dmcsvoices/Handoff-Case/designs/handoff_case/IMG_20261020_133205997.jpg

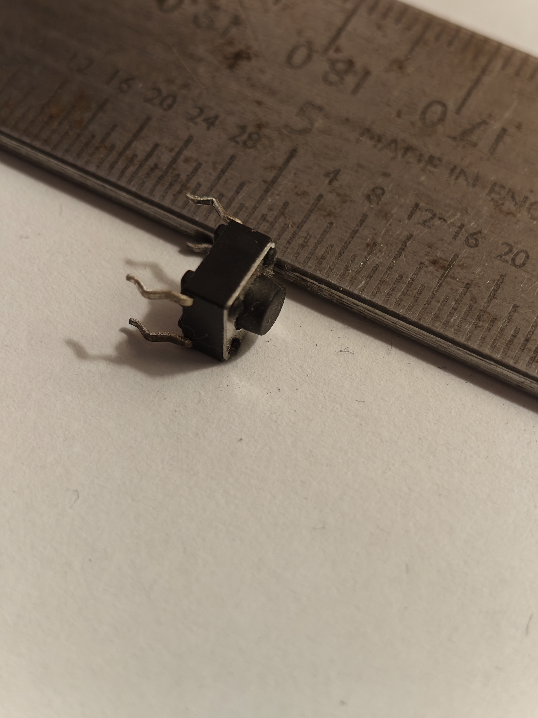
designs/handoff_case/IMG_20261020_133205997.jpg
