dmcsvoices/Handoff-Case/plans/current/index.md

# Current Plans Index

Format: `created_at | path | title | summary`

2026-10-29-20-30-00 | plans/current/2026-10-29-20-30-00_handoff-case-rev2-feedback.md | Handoff Case rev_0002 — physical print feedback + button holding slots | Apply 2026-10-29 caliper/print feedback (board 57.1, USB shells 4.4, OLED 31.0 rigid, microSD module, button 5.4 mm body) and replace button wells with side-entry holding slots that accept pre-wired switches, as immutable rev_0002.
2026-10-20-14-26-10 | plans/current/2026-10-20-14-26-10_handoff-case.md | Handoff Case — ESP32-S3 IoT Device Enclosure | Design a governed OpenSCAD enclosure for an ESP32-S3 DevKitC, microSD reader module + card, 1.3" I2C OLED, and two tactile buttons, from a fresh pipeline scaffold using ruler-photo measurements.
2026-10-16-22-00-00 | plans/current/2026-10-16-22-00-00_cicero-head-gravity-joints.md | Implement gravity-seated joints for the Cicero head | Resolve a continuous neck owner, add installable head joints, and verify flat-bed outputs.
2026-10-04-11-35-16 | plans/current/2026-10-04-11-35-16_create-6u-cyberdeck.md | Create 6u_cyberdeck 6U ten-inch-rack case (80 mm deep) | Build a new standalone 6U ten-inch-rack case (254 x 293.9 x 80 mm outer, 222.25 x 266.7 mm clear opening) split into four printable quadrant leaves joined by M3 captive-nut registration seam stations; ring band 13.6 mm independently derived from the M3 station starting profile.
2026-09-18-12-00-00 | plans/current/2026-09-18-12-00-00_fan-guard.md | Micro Cyberdeck Fan Guard | Add a new single-part fan guard design — a flat plate on 3 mm standoffs with four M3-bore studs — that sits outside the case's 40 mm fan, keeps airflow in through the sides and center, and protects the spinning blades.
2026-09-18-07-21-14 | plans/current/2026-09-18-07-21-14_solarpunk-seed-tray-bell-bumpout.md | Solarpunk Seed Tray — Bell Bump-Out | Move the siphon out of the tray footprint into a side bump-out sized for an ~8 cm bottle, with a center siphon exit, 8 support spines (~5 mm), and a drain outlet on the bump-out outer face; 12-cell (rev_0001) is the primary reference.
2026-09-17-16-59-53 | plans/current/2026-09-17-16-59-53_solarpunk-seed-tray-parametric-scaffold.md | Solarpunk Seed Tray Parametric Scaffold | Build the fully-parametric solarpunk_seed_tray OpenSCAD source, two placeholder configs (12-cell and 6-cell kits), reference mockups, and manifest/assembly governance so adding a size never requires editing src/.
2026-09-09-19-21-26 | plans/current/2026-09-09-19-21-26_create-cyberdeck-2-5u-enclosure.md | Create cyberdeck-2 5U fully-enclosed rack case | Build a new 5U ten-inch-rack case (254 x 254 x 80 mm), fully enclosed except the 222.25 x 222.25 mm rack opening, split into four printable quadrant leaves joined by eight M3 captive-nut registration seam stations (two per seam ribbon) located in the ring band between the rack clear opening and the case edge.
2026-08-31-12-58-00 | plans/current/2026-08-31-12-58-00_triple-thor-geometry-blockout.md | Triple Thor Enclosure Geometry Blockout | Scaffold parametric OpenSCAD blockout geometry, parts manifest, assembly contract, and config for the triple_thor_enclosure at locked R=57mm layout.
2026-08-13-17-44-00 | plans/current/2026-08-13-17-44-00_restore-angled-screen-2u-rails.md | Restore Distinct Angled-Screen 2U Rails | Separate the angled-screen rail, hardware-back, and exterior-closure owners so the screen presents two clear 2U rail columns rather than solid end-wall blocks.
2026-08-04-19-34-43 | plans/current/2026-08-04-19-34-43_migrate-agents-to-agentic-pipelines.md | Migrate the Agent Framework to Agentic Pipelines | Replace the agents submodule with agentic-pipelines at ./agentic-pipelines while preserving and validating host-owned CAD governance.
2026-08-03-11-23-45 | plans/current/2026-08-03-11-23-45_relocate-upper-seam-and-fastener-rail.md | Connect the High Screen Roof and Relocate the Upper Front Seam | Add a clearance-neutral interlocking seam to the highest screen roof, move the closed-front upper seam into its inside wall, and reduce chamber height only if the full upper load path remains verified.
