dmcsvoices/Handoff-Case/plans/current/2026-10-20-14-26-10_handoff-case.md

---
plan_id: 2026-10-20-14-26-10_handoff-case
title: Handoff Case — ESP32-S3 IoT Device Enclosure
summary: Design a governed OpenSCAD enclosure for an ESP32-S3 DevKitC, microSD reader module + card, 1.3" I2C OLED, and two tactile buttons, from a fresh pipeline scaffold using ruler-photo measurements.
status: current
created_at: 2026-10-20-14-26-10
---

# Handoff Case — ESP32-S3 IoT Device Enclosure

Key: `[ ]` pending task, `[x]` completed task, `[?]` needs validation, `[-]` closed task

Approved design intent (2026-10-20 user decisions): fresh governed design (prior
`reference/handoff_case.scad` is history only, not carried geometry); base + M3
screwed lid; ESP32-S3 on slide-in edge rails; free tactile buttons + printed caps;
Dupont jumper wiring kept with strain relief; PLA filament; walls/overlap/internal
edges at the 3.0 mm house norm.

- [ ] 1. Reference measurement pass (per `playbooks/how_to_model_real_world_interfaces_from_photos_and_measurements.md`).
  - [x] 1.1 Survey all 32 photos in `designs/handoff_case/` and extract ruler-scaled dimensions for: ESP32-S3 board (L×W×H envelope, USB connector positions/sizes, RST/BOOT keep-outs, header row extents), OLED module (PCB outline, display window, mounting-hole span), SD reader module (PCB outline, cage + inserted-card envelope, slot centerline height), tactile buttons (body, actuator, height).
  - [x] 1.2 Supplement photo gaps with manufacturer-specified dimensions (Espressif DevKitC-1 mechanical drawing, module vendor dimensions) and classify every critical dimension as measured / manufacturer-specified / derived / provisional in the design README provenance table.
- [ ] 2. Design scaffold (per `playbooks/how_to_add_a_new_cad_design.md`).
  - [x] 2.1 Create `designs/handoff_case/src/main.scad`, `src/lib/defaults.scad`, `src/parts/*.scad`, `configs/rev_0001.json`, and `designs/handoff_case/README.md` declaring `minimum_wall_thickness = minimum_structural_overlap = minimum_internal_edge_width = 3.0`, datum convention (outer-front-left-bottom at origin), and the dimension provenance table.
  - [x] 2.2 Create `parts.json` declaring printable leaves (base, lid, button_cap) plus non-printable mockup parts for the four components, classified per `playbooks/how_to_manage_reference_mockups_and_non_printable_geometry.md`, with `main.scad` dispatch synchronized to numeric part ids.
  - [x] 2.3 Create `assembly.json` (product assembly: base+lid joint, component mockup placement transforms, review dispatch) and pass `scripts/validate_cad_assembly_contract.py`.
- [ ] 3. Geometry build.
  - [x] 3.1 Blockout: base + lid shell envelopes with wall asserts and all component mockups placed at planned faces (OLED front, SD slot side wall, USB back, buttons on lid); run complete build + audit on the blockout.
  - [x] 3.2 Base detail: ESP32 slide-in edge rails + closed end stop; OLED screw-down bosses (inside face); SD module pocket + through-wall card slot; button body pockets; USB cutout(s) per measured connector positions; vent slots; strain-relief posts for Dupont runs.
  - [x] 3.3 Lid detail: four M3 stud towers with Ø3.2 pilot bores and full 3 mm wall overlap; lid clearance bores with countersunk heads; button-cap guide bores aligned to base pockets.
  - [x] 3.4 Button cap part (printed ×2) sized to the measured actuator with a printed fit clearance.
- [ ] 4. Verification.
  - [x] 4.1 Structural review per `playbooks/how_to_design_and_verify_structural_openscad_joins.md`: every join ≥ 3.0 mm positive-volume overlap, ligament asserts for every hole/boss/rail pair, section renders, no unexpected disconnected shells; record results in the design README.
  - [x] 4.2 Fit review per `playbooks/how_to_design_and_validate_fit_clearances_and_tolerance_stacks.md`: clearance table vs measurements (rails, pocket, caps, card slot); produce one fit-test coupon for the highest-risk mating profile and mark unfit interfaces `unverified`.
  - [x] 4.3 Complete gate: `scad_build_all.py` build + `--audit-only` pass, review of installed STL/PNG artifacts, then artifact-bound assembly review (`scad_render_assembly_review.py --set full` + audit) bound to the exact `build_manifest.json` and STL hashes.
- [ ] 5. Documentation and checkpoint.
  - [ ] 5.1 Update `README.md` (design list + one-line entry), record today's work in `journal/2026-10-20.md`, and keep `AGENTS.md`/playbooks untouched unless workflow changed.
  - [ ] 5.2 Regenerate and check plan indexes; review the full diff; propose task-scoped commit message(s); commit (and push only if requested) after explicit approval.

## Open items to resolve during execution

- USB access: measure both USB-C connectors from photos; single shared cutout vs
  aligned per-connector cutouts — decide with user at artifact review if ambiguous.
- Display driver identity (SSD1306 vs SH1106) affects firmware only, not geometry;
  window dims come from photos either way.
- SD card slot lands on the right side wall unless measurements say otherwise.

## Authoring Rules

- Use `YYYY-MM-DD-HH-mm-ss_slug.md` with a lowercase, hyphenated slug.
- Make `plan_id` match the filename stem exactly.
- Use only the required front matter keys shown above.
- Decompose work until each leaf item has one clear completion condition.
- Use `[-]` only for intentionally closed or de-scoped work.
- Keep file location aligned to `future`, `current`, or `past` status.
