dmcsvoices/Handoff-Case/designs/handoff_case/IMG_20261020_132310760.jpg

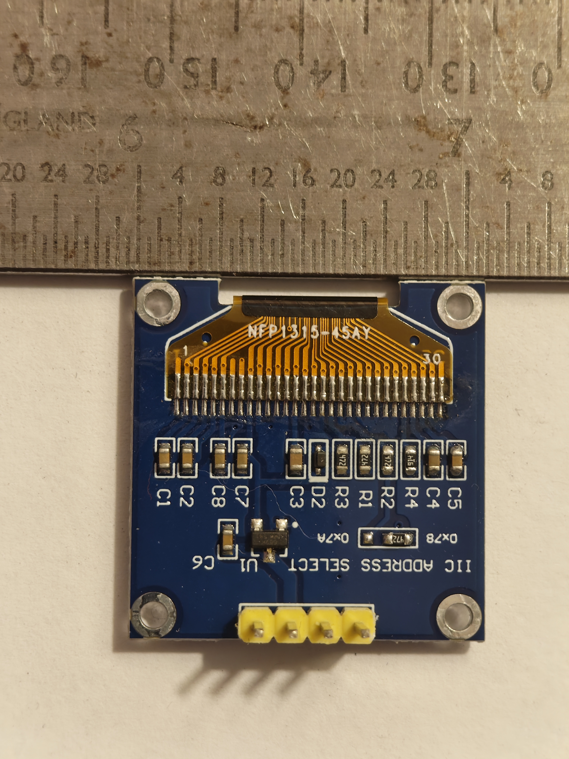
designs/handoff_case/IMG_20261020_132310760.jpg
