dmcsvoices/Handoff-Case/designs/handoff_case/IMG_20261020_132324795.jpg

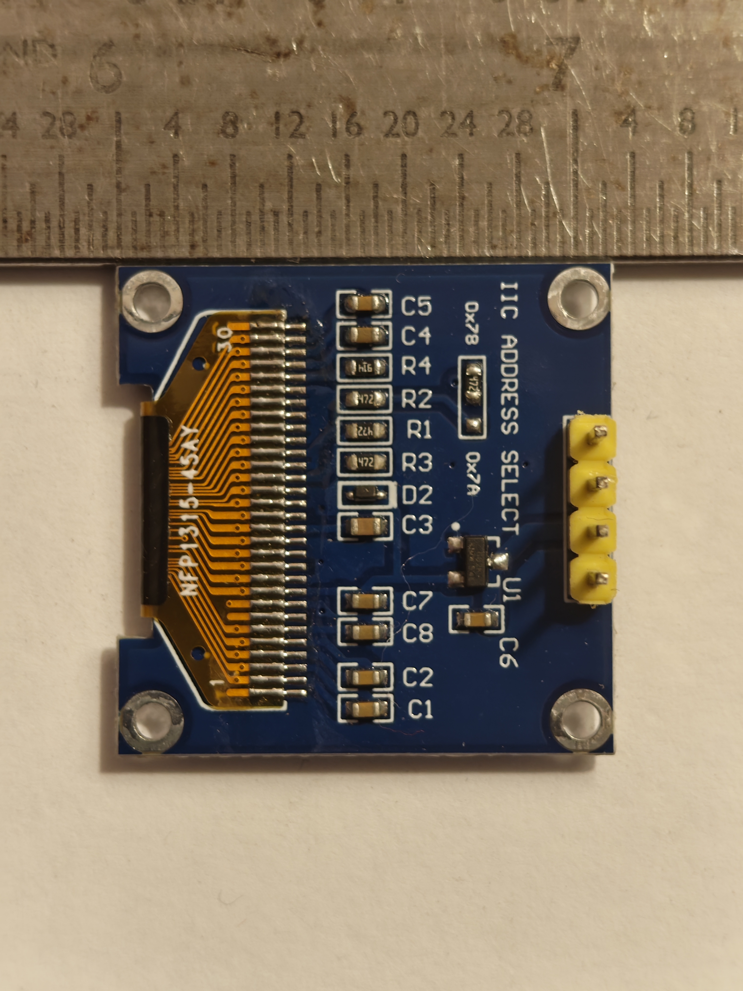
designs/handoff_case/IMG_20261020_132324795.jpg
