dmcsvoices/Handoff-Case/designs/handoff_case/IMG_20261020_132353154.jpg

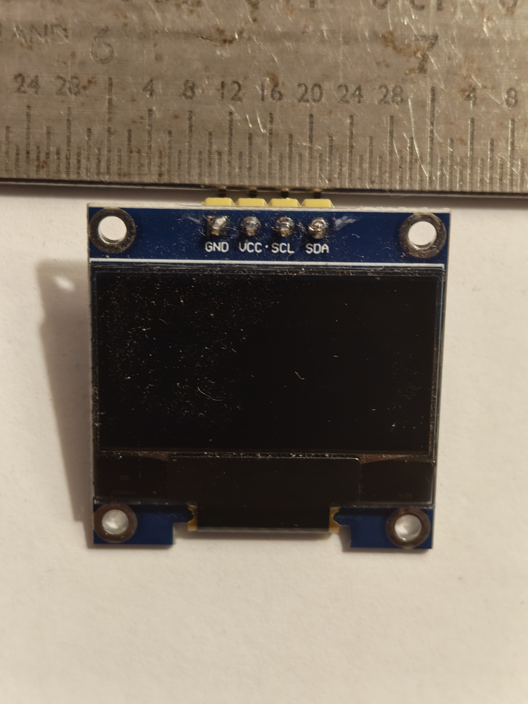
designs/handoff_case/IMG_20261020_132353154.jpg
