dmcsvoices/Handoff-Case/designs/handoff_case/IMG_20261020_132410037.jpg

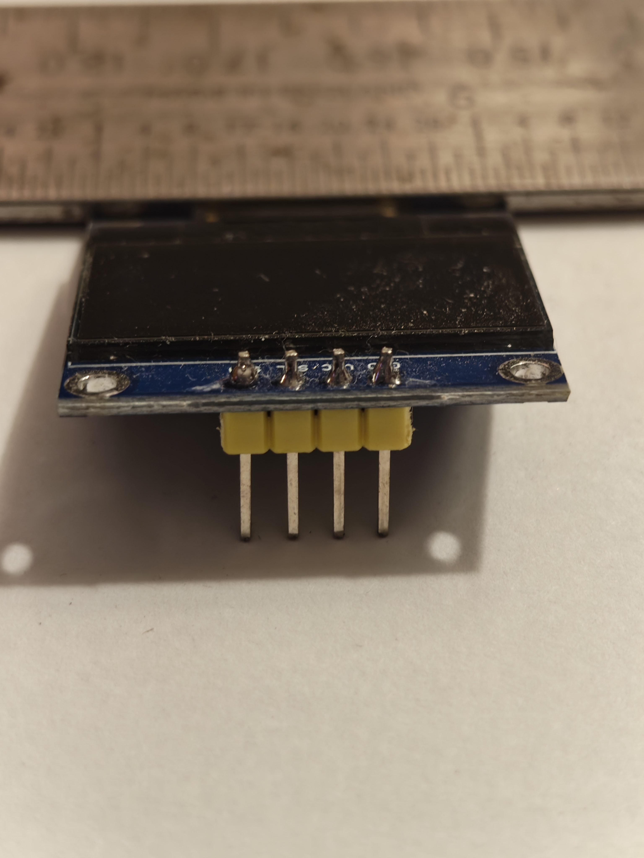
designs/handoff_case/IMG_20261020_132410037.jpg
