dmcsvoices/Handoff-Case/designs/handoff_case/IMG_20261020_132823366.jpg

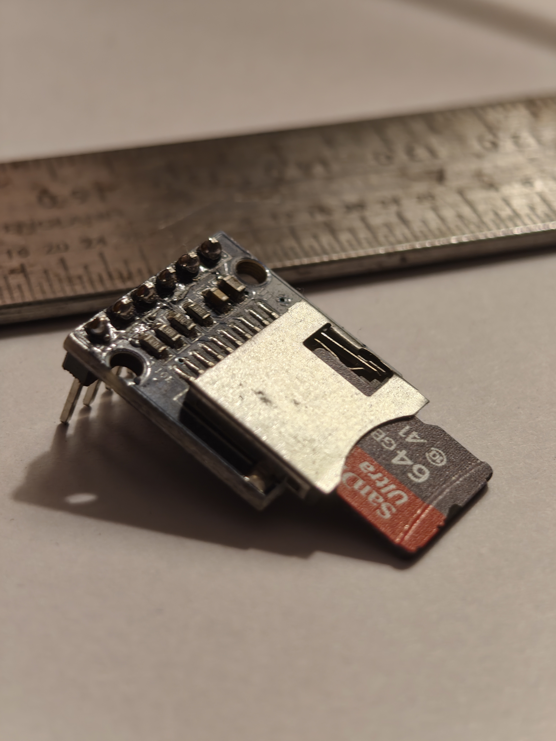
designs/handoff_case/IMG_20261020_132823366.jpg
