dmcsvoices/Handoff-Case/designs/handoff_case/IMG_20261020_132851913.jpg

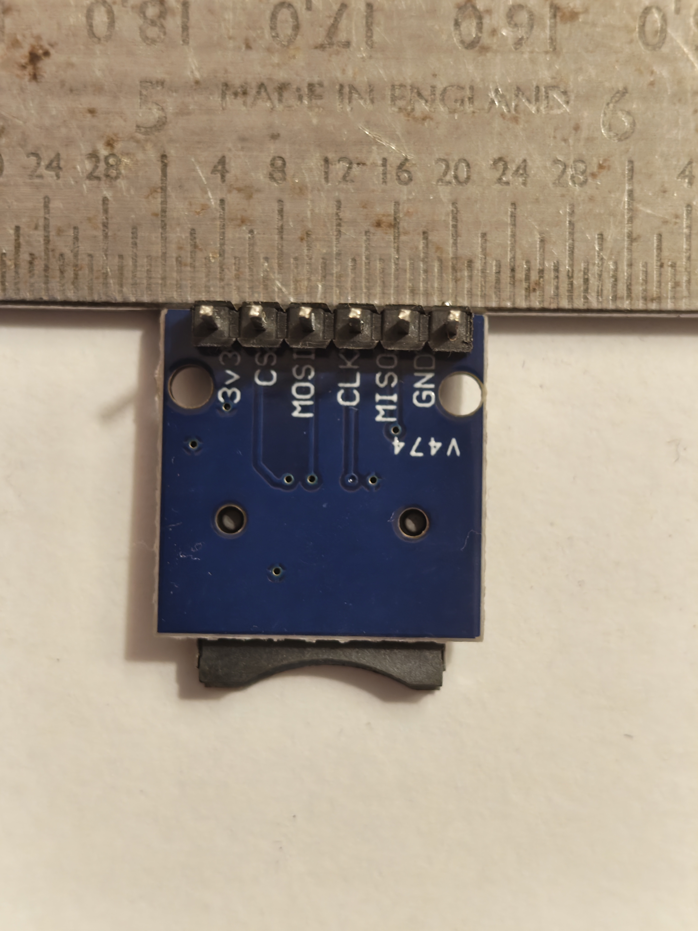
designs/handoff_case/IMG_20261020_132851913.jpg
