dmcsvoices/Handoff-Case/designs/handoff_case/IMG_20261020_132917582.jpg

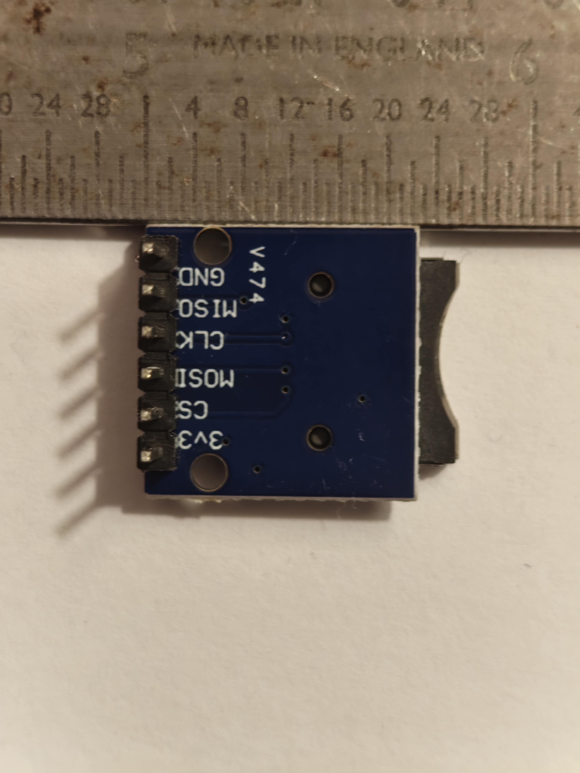
designs/handoff_case/IMG_20261020_132917582.jpg
