dmcsvoices/Handoff-Case/designs/handoff_case/IMG_20261020_132930378.jpg

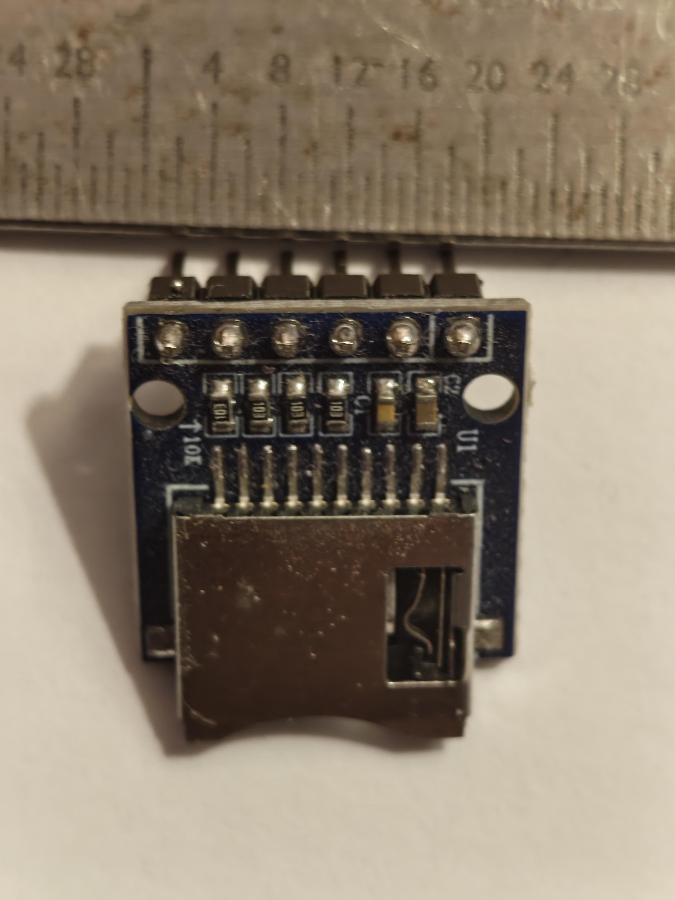
designs/handoff_case/IMG_20261020_132930378.jpg
