dmcsvoices/Handoff-Case/designs/handoff_case/IMG_20261020_132958653.jpg

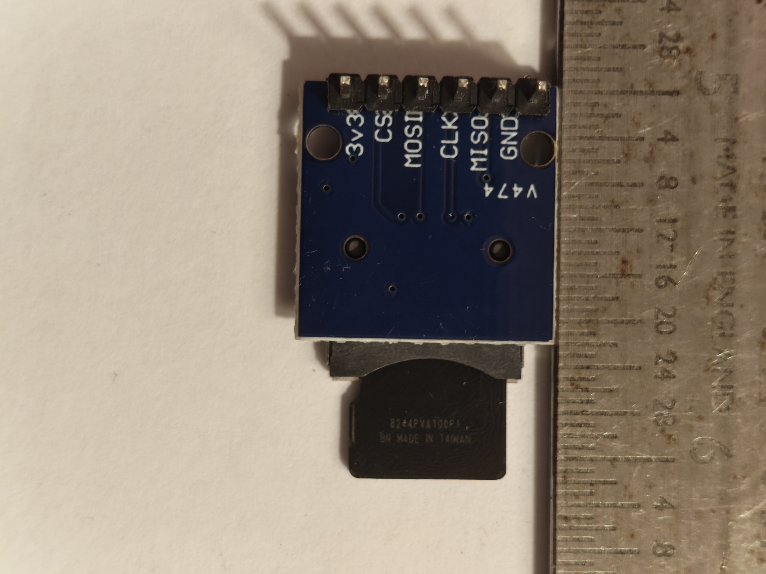
designs/handoff_case/IMG_20261020_132958653.jpg
