dmcsvoices/Handoff-Case/designs/handoff_case/IMG_20261020_133024415.jpg

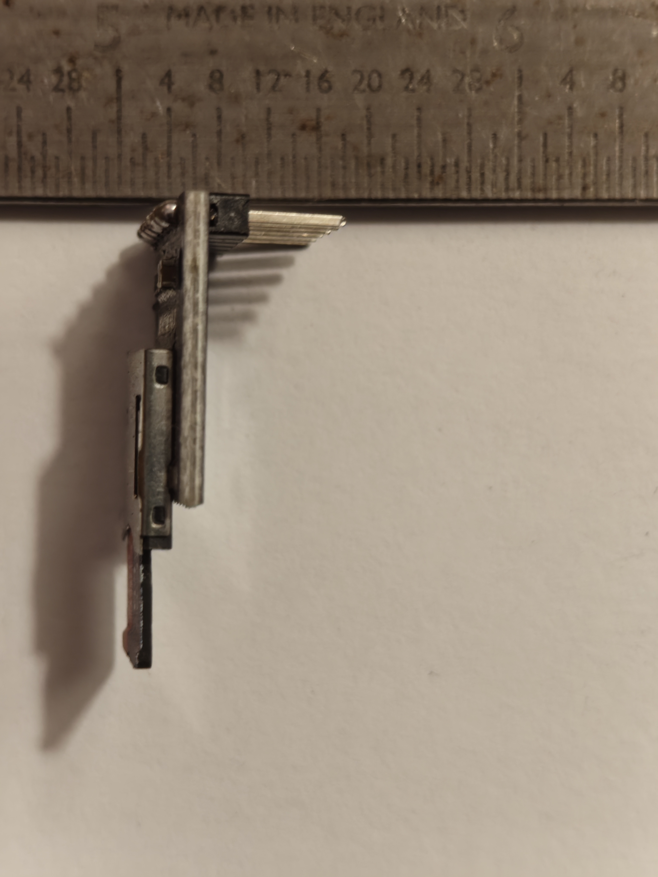
designs/handoff_case/IMG_20261020_133024415.jpg
