dmcsvoices/Handoff-Case/designs/handoff_case/IMG_20261020_133124452.jpg

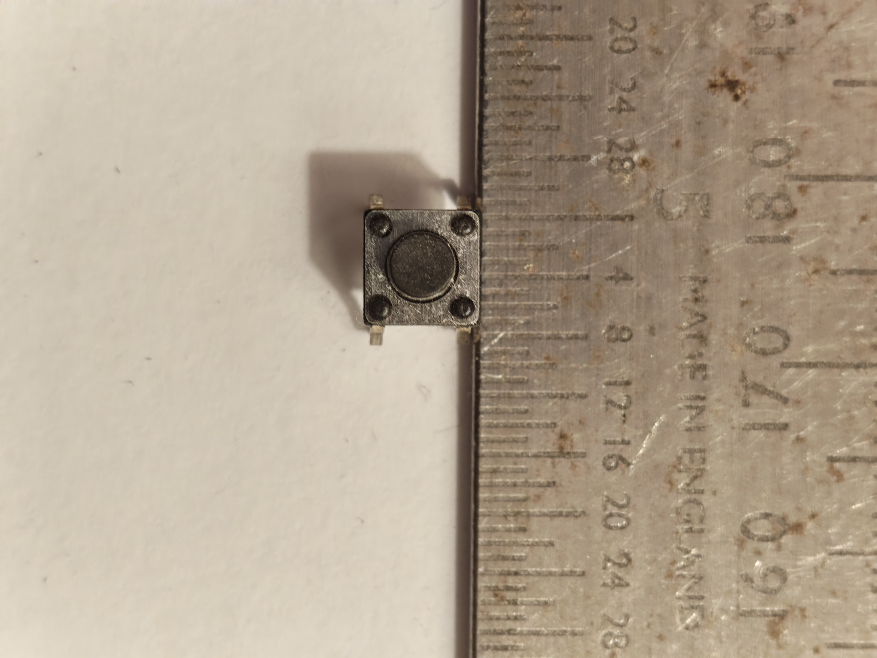
designs/handoff_case/IMG_20261020_133124452.jpg
