dmcsvoices/Handoff-Case/designs/handoff_case/IMG_20261020_133133115.jpg

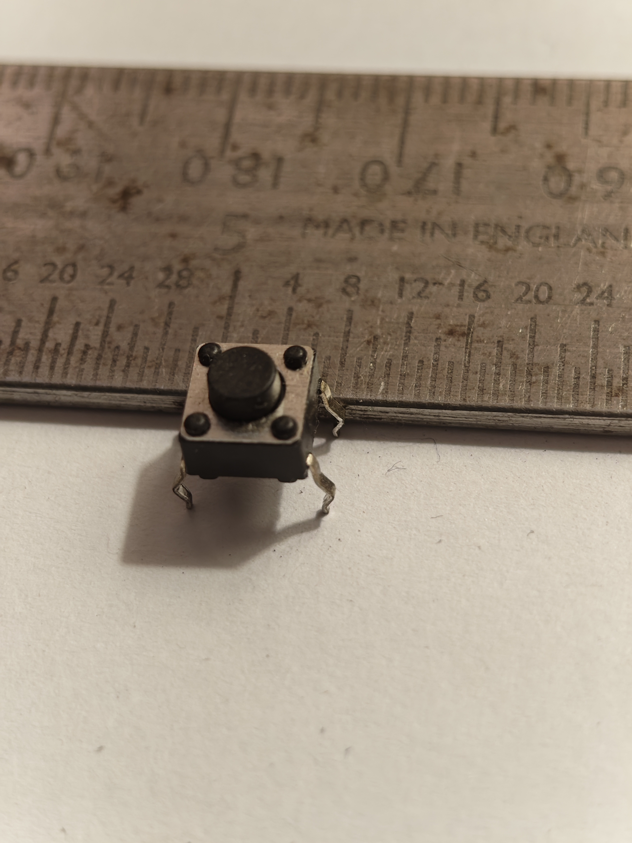
designs/handoff_case/IMG_20261020_133133115.jpg
