dmcsvoices/Handoff-Case/designs/handoff_case/IMG_20261020_133159837.jpg

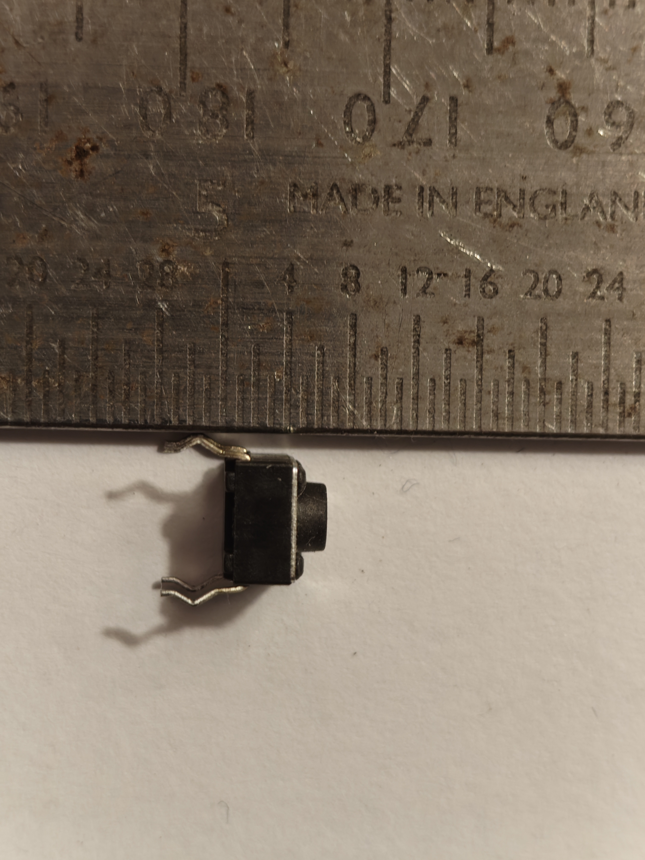
designs/handoff_case/IMG_20261020_133159837.jpg
