dmcsvoices/Handoff-Case/designs/handoff_case/IMG_20261020_133657593.jpg

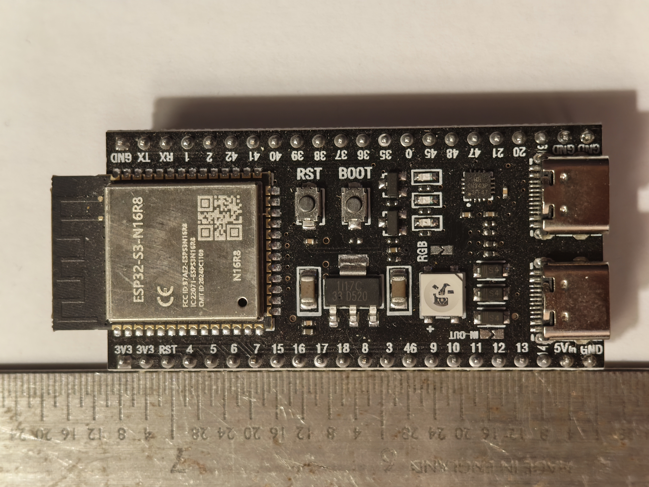
designs/handoff_case/IMG_20261020_133657593.jpg
