dmcsvoices/Handoff-Case/designs/handoff_case/IMG_20261020_133727599.jpg

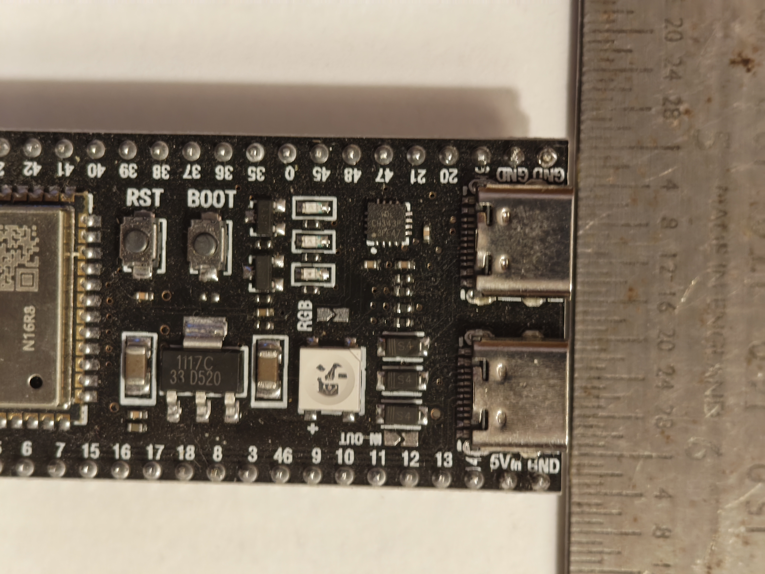
designs/handoff_case/IMG_20261020_133727599.jpg
