dmcsvoices/Handoff-Case/designs/handoff_case/IMG_20261020_133752373.jpg

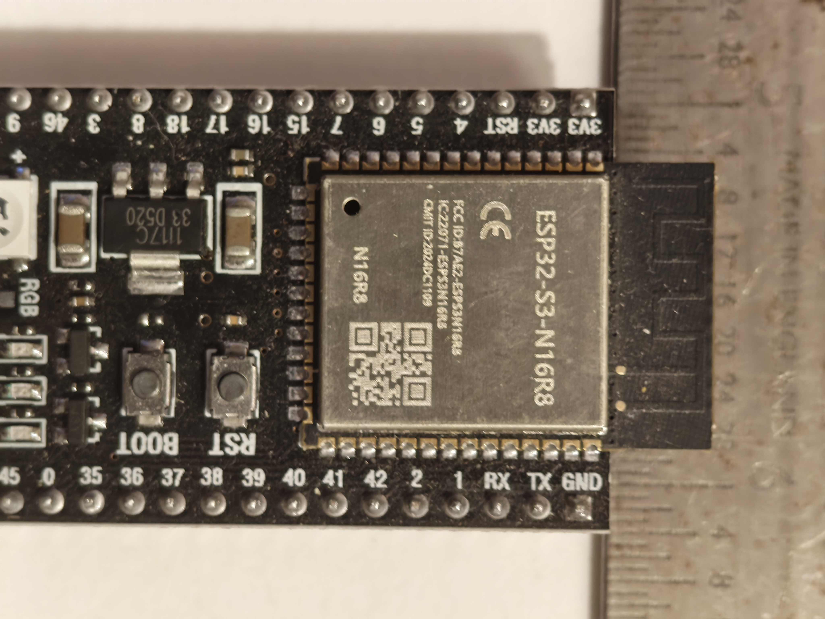
designs/handoff_case/IMG_20261020_133752373.jpg
