dmcsvoices/Handoff-Case/designs/handoff_case/IMG_20261020_133754685.jpg

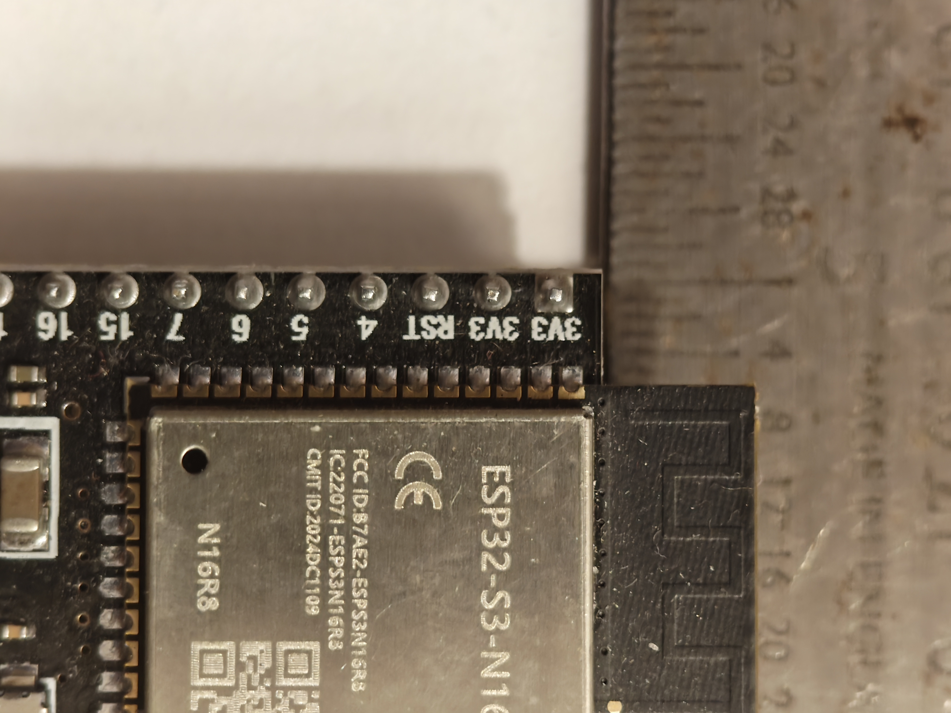
designs/handoff_case/IMG_20261020_133754685.jpg
