dmcsvoices/Handoff-Case/designs/handoff_case/IMG_20261020_133801292.jpg

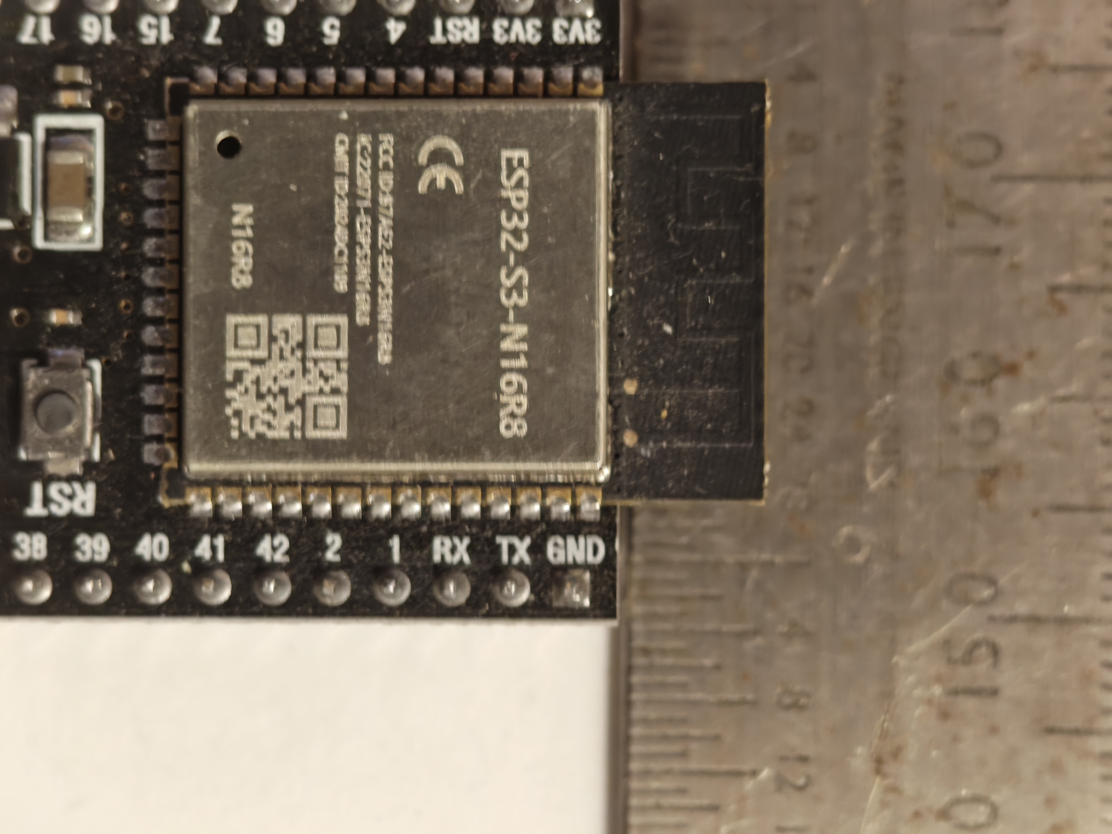
designs/handoff_case/IMG_20261020_133801292.jpg
