dmcsvoices/Handoff-Case/designs/handoff_case/IMG_20261020_133842431.jpg

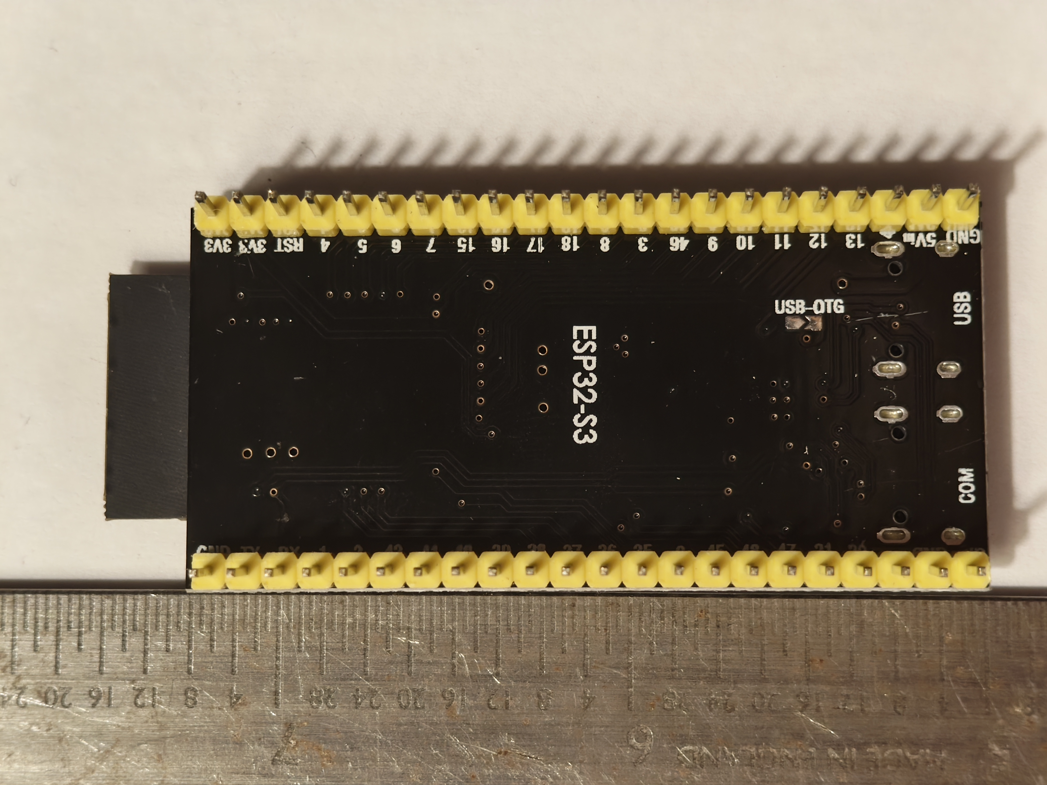
designs/handoff_case/IMG_20261020_133842431.jpg
