dmcsvoices/Handoff-Case/designs/handoff_case/IMG_20261020_133858708.jpg

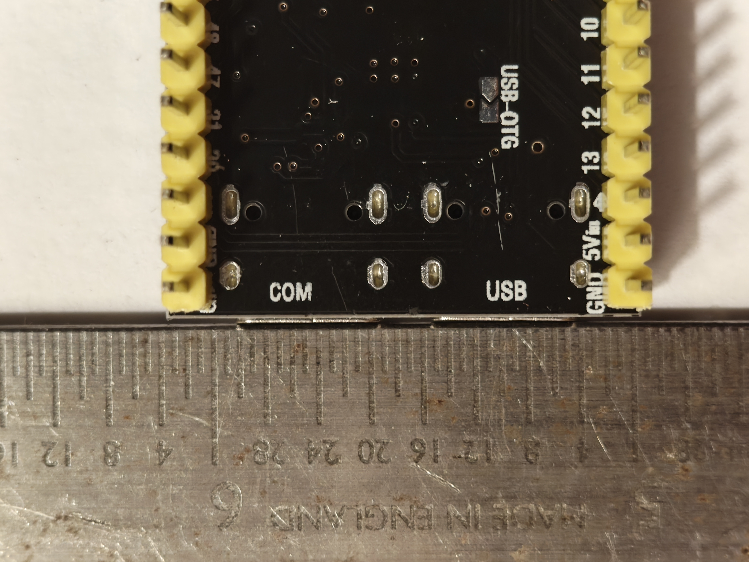
designs/handoff_case/IMG_20261020_133858708.jpg
