dmcsvoices/Handoff-Case/designs/handoff_case/IMG_20261020_133910038.jpg

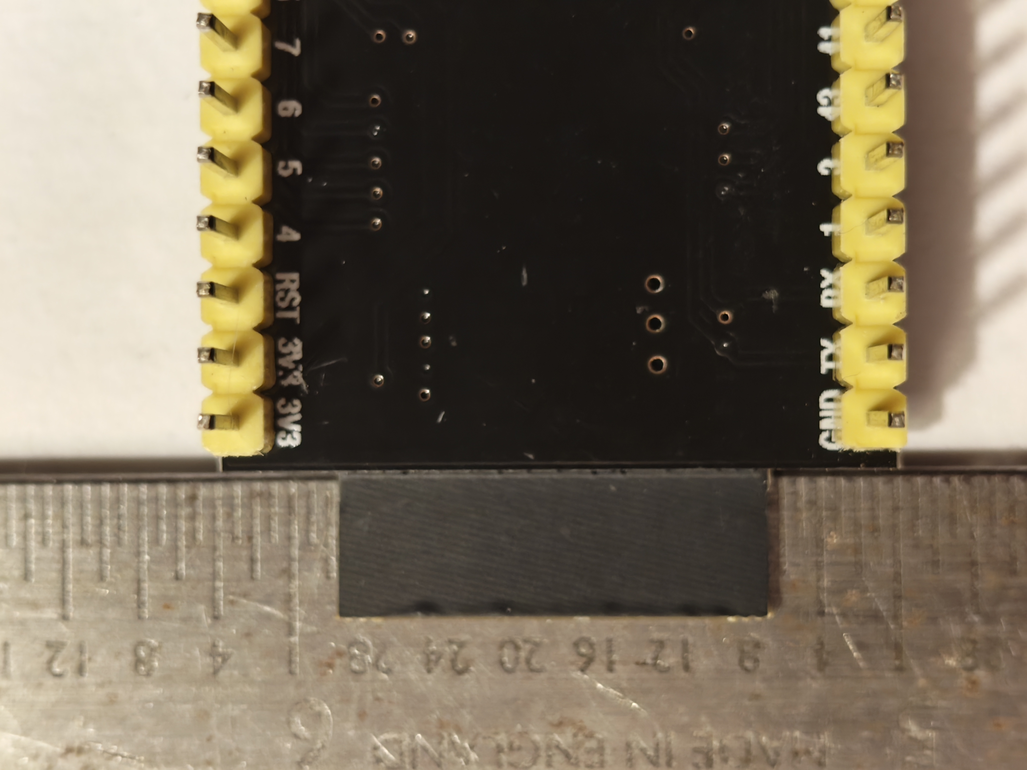
designs/handoff_case/IMG_20261020_133910038.jpg
