dmcsvoices/Handoff-Case/designs/handoff_case/IMG_20261020_133915907.jpg

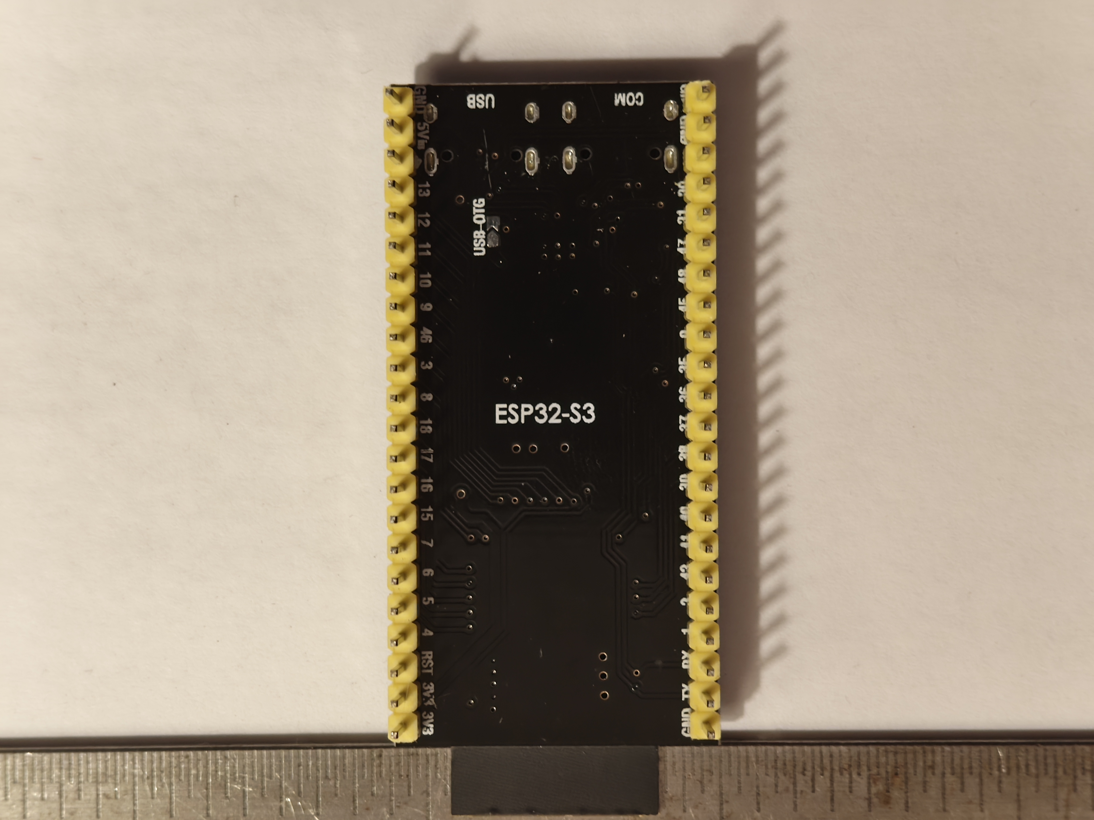
designs/handoff_case/IMG_20261020_133915907.jpg
