dmcsvoices/Handoff-Case/designs/handoff_case/IMG_20261020_134055205.jpg

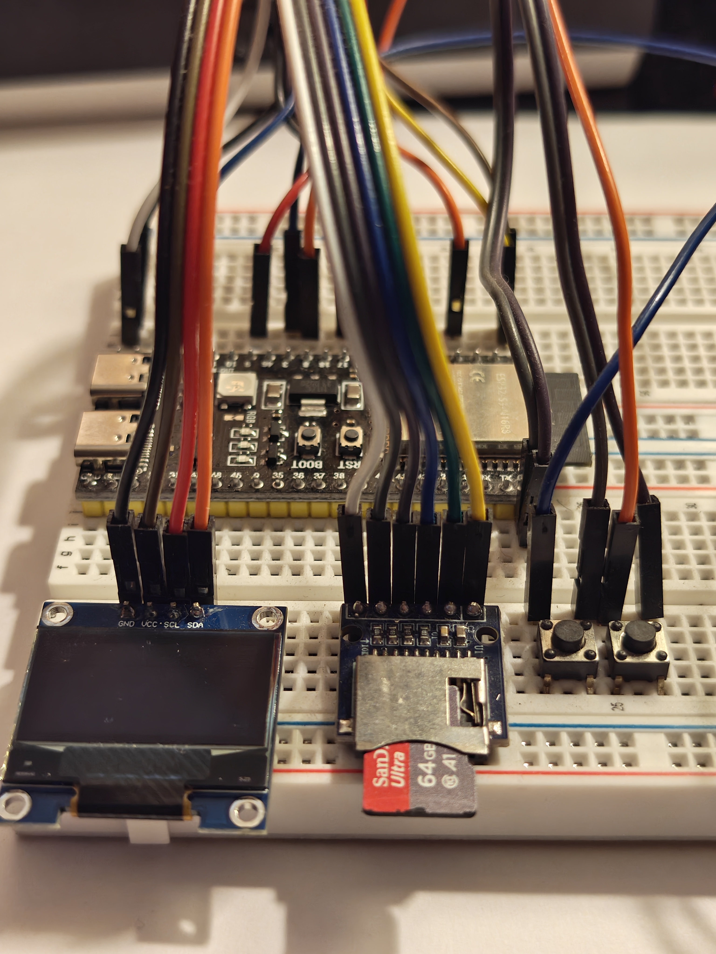
designs/handoff_case/IMG_20261020_134055205.jpg
