dmcsvoices/Handoff-Case/designs/handoff_case/IMG_20261020_134130135.jpg

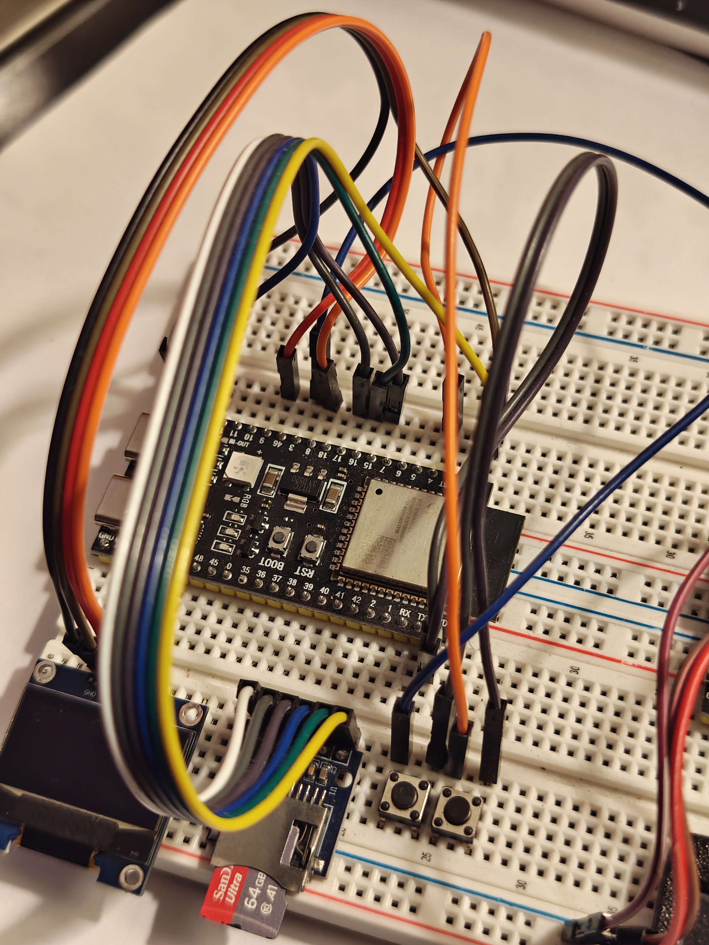
designs/handoff_case/IMG_20261020_134130135.jpg
