dmcsvoices/Handoff-Case/designs/handoff_case/IMG_20261020_134139442.jpg

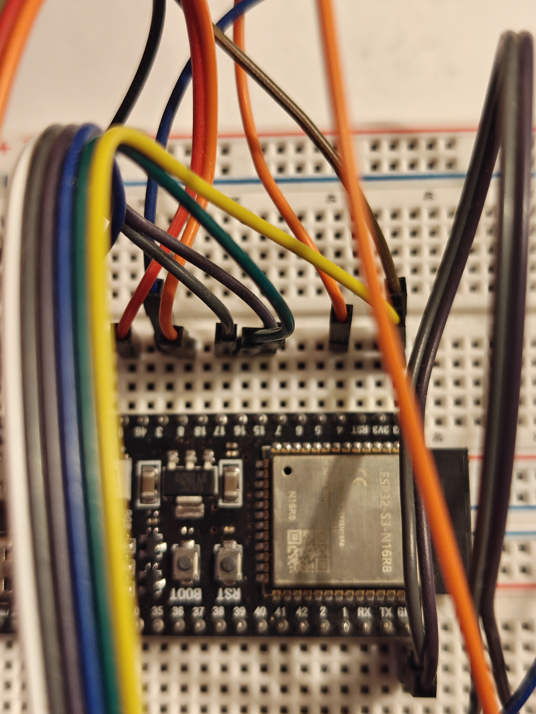
designs/handoff_case/IMG_20261020_134139442.jpg
