dmcsvoices/Handoff-Case/designs/handoff_case/IMG_20261020_134144807.jpg

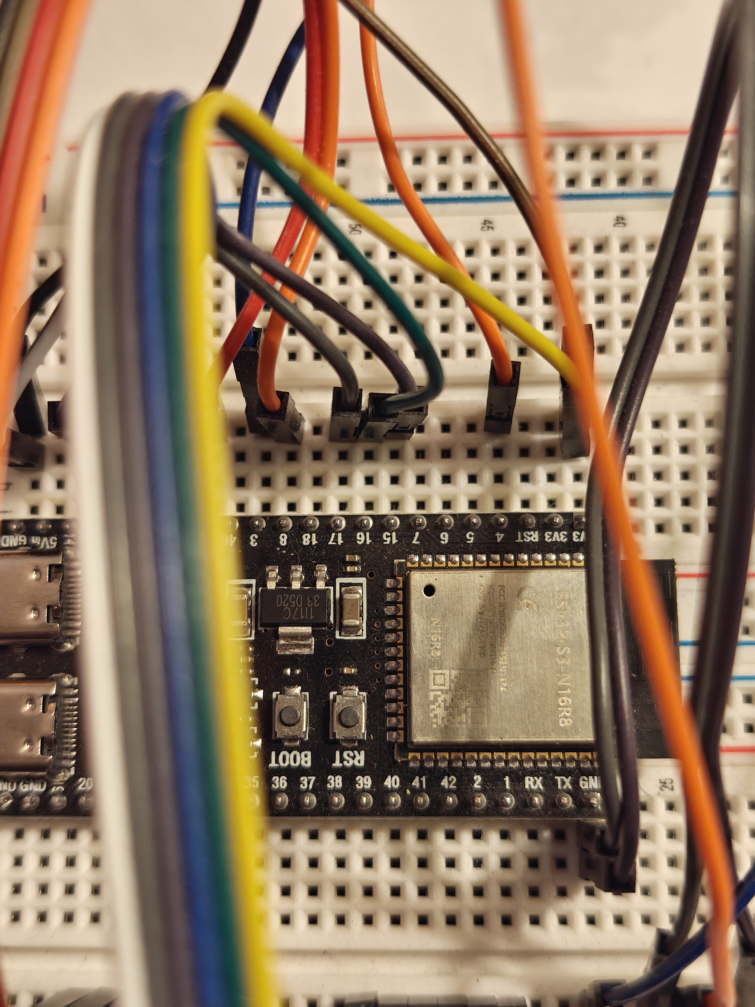
designs/handoff_case/IMG_20261020_134144807.jpg
