dmcsvoices/Handoff-Case/designs/handoff_case/IMG_20261020_134149637.jpg

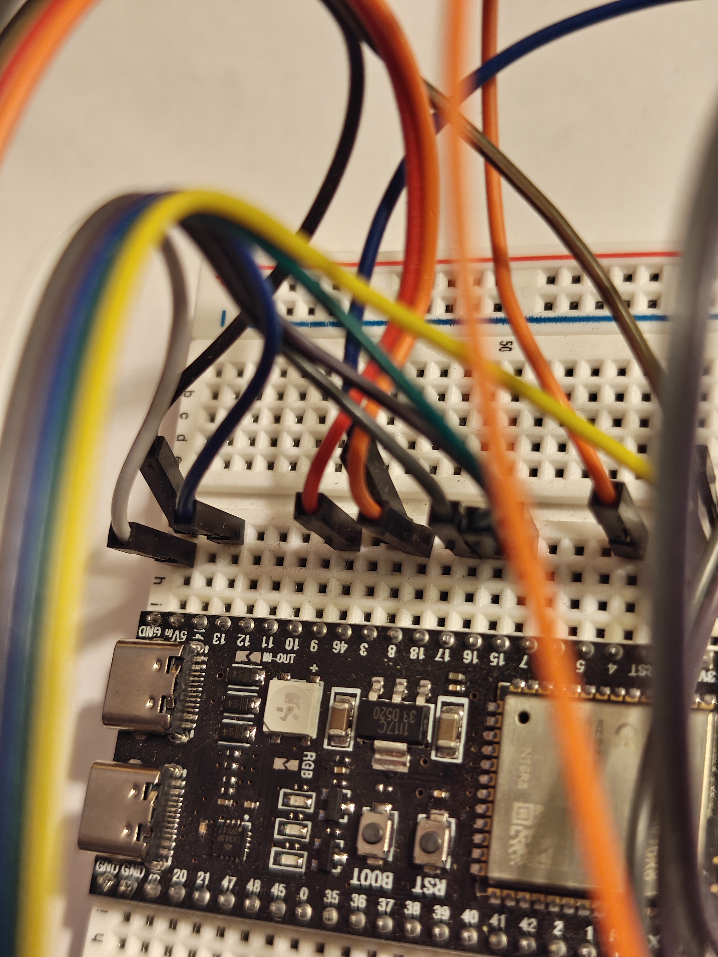
designs/handoff_case/IMG_20261020_134149637.jpg
