dmcsvoices/Handoff-Case/designs/handoff_case/IMG_20261020_134157366.jpg

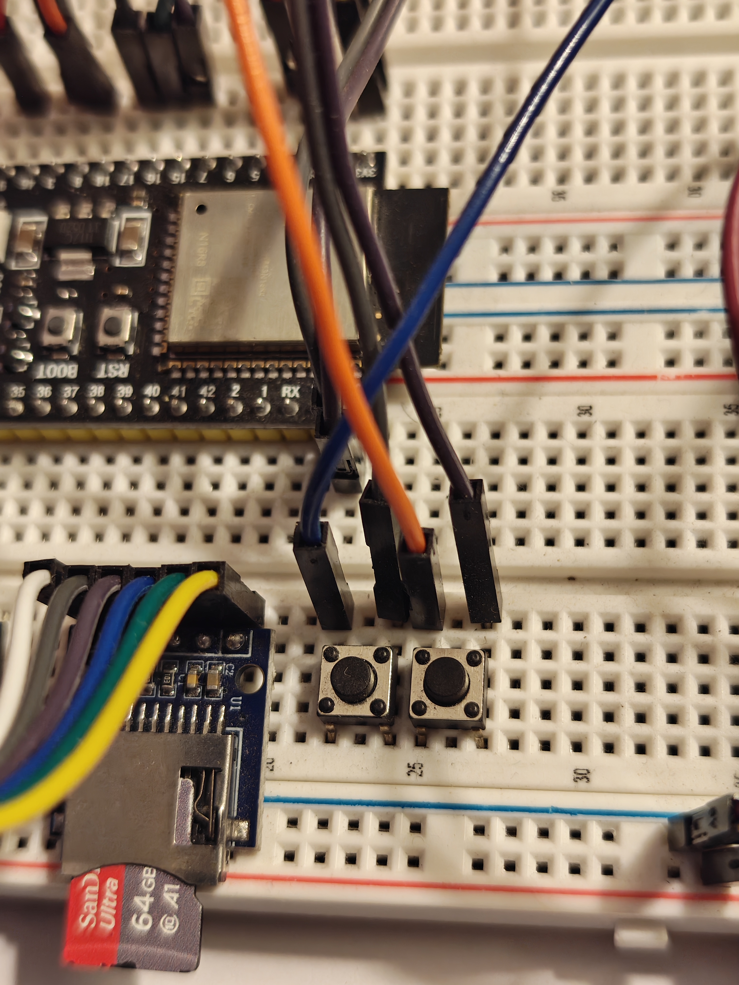
designs/handoff_case/IMG_20261020_134157366.jpg
