dmcsvoices/Handoff-Case/designs/handoff_case/IMG_20261020_134212339.jpg

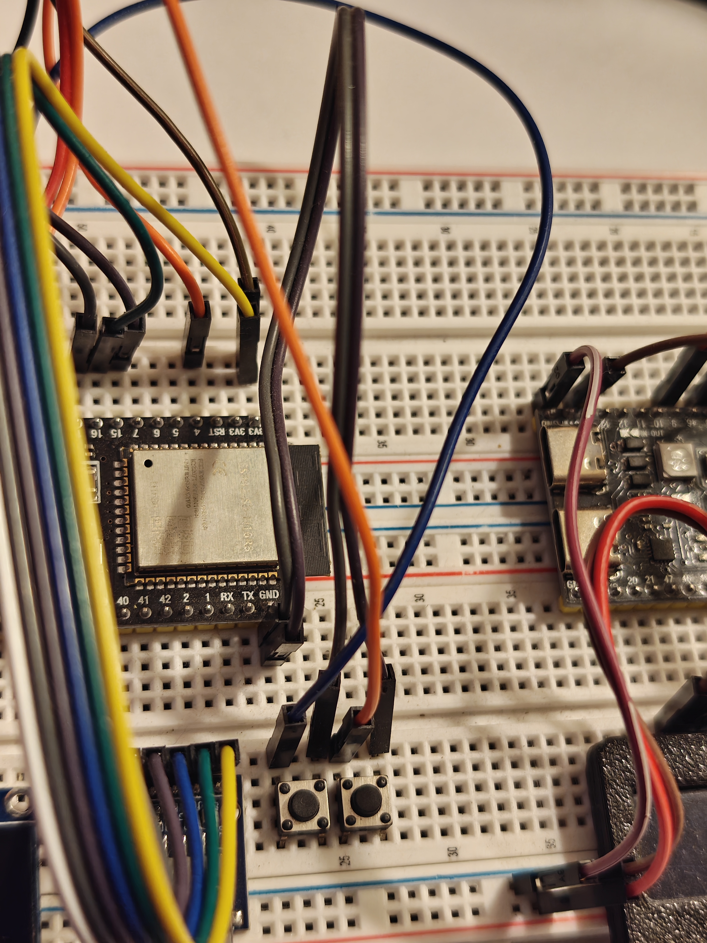
designs/handoff_case/IMG_20261020_134212339.jpg
