dmcsvoices/Handoff-Case/designs/handoff_case/IMG_20261020_134227664.jpg

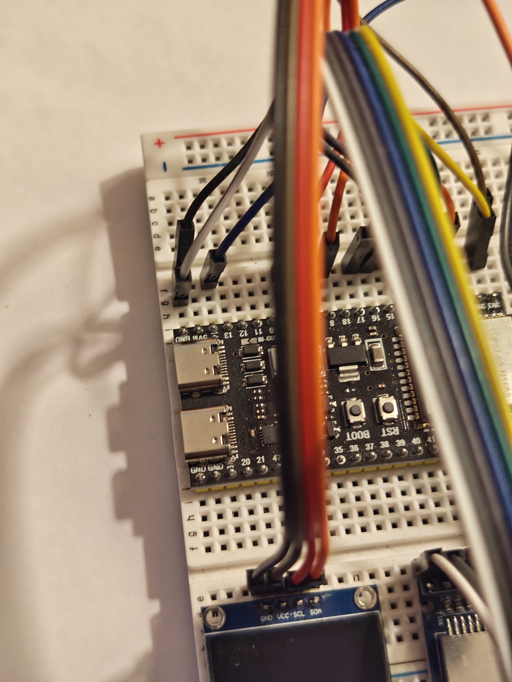
designs/handoff_case/IMG_20261020_134227664.jpg
