dmcsvoices/Handoff-Case/designs/handoff_case/IMG_20261020_134240331.jpg

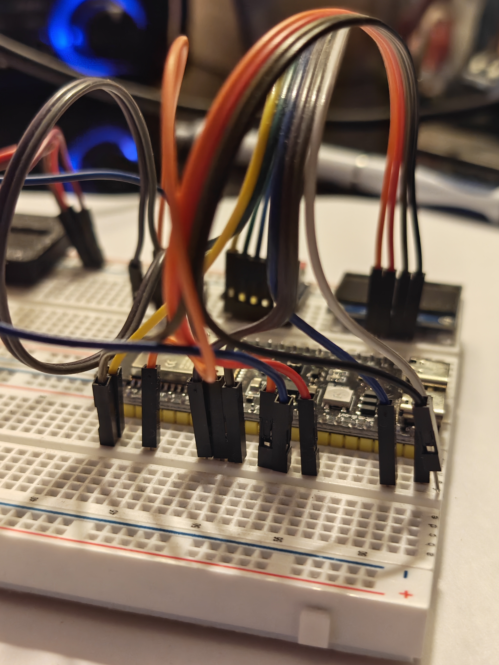
designs/handoff_case/IMG_20261020_134240331.jpg
