dmcsvoices/Handoff-Case/output/handoff_case/base_rev_0002_iso_front_left.png

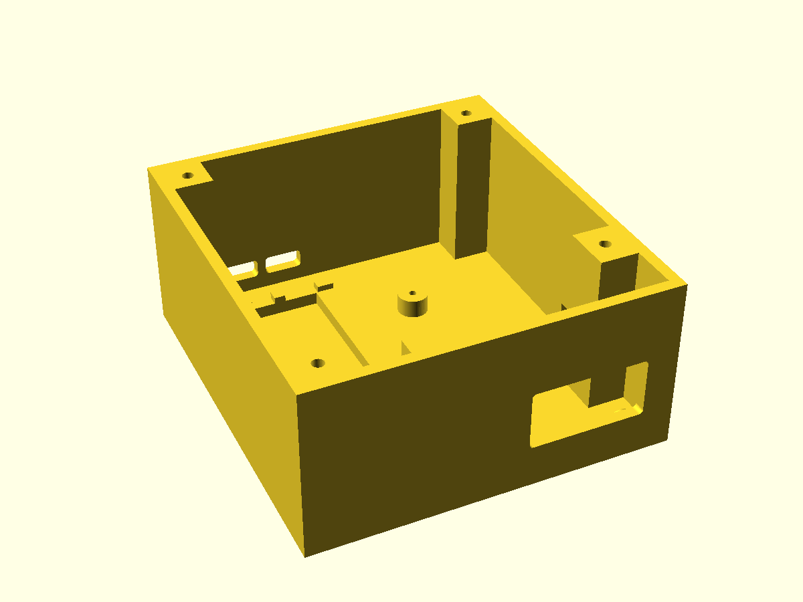
output/handoff_case/base_rev_0002_iso_front_left.png
