dmcsvoices/Handoff-Case/output/handoff_case/base_rev_0002_ortho_bottom.png

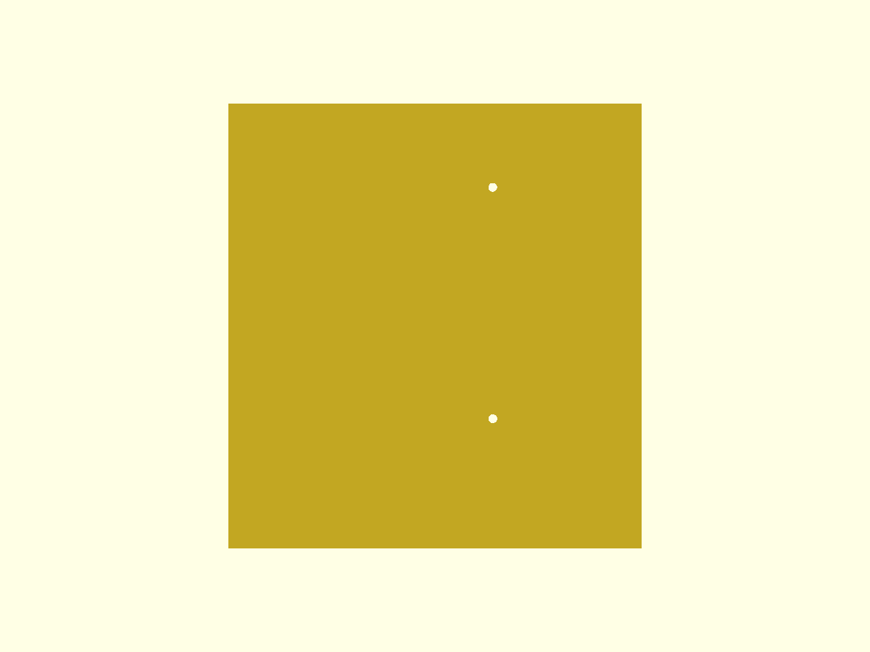
output/handoff_case/base_rev_0002_ortho_bottom.png
