dmcsvoices/Handoff-Case/output/handoff_case/base_rev_0002_ortho_right.png

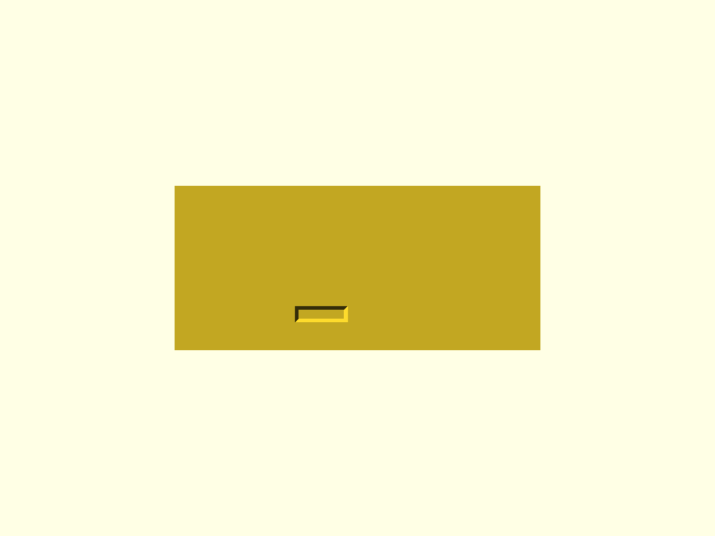
output/handoff_case/base_rev_0002_ortho_right.png
