dmcsvoices/Handoff-Case/output/handoff_case/button_cap_rev_0002.png

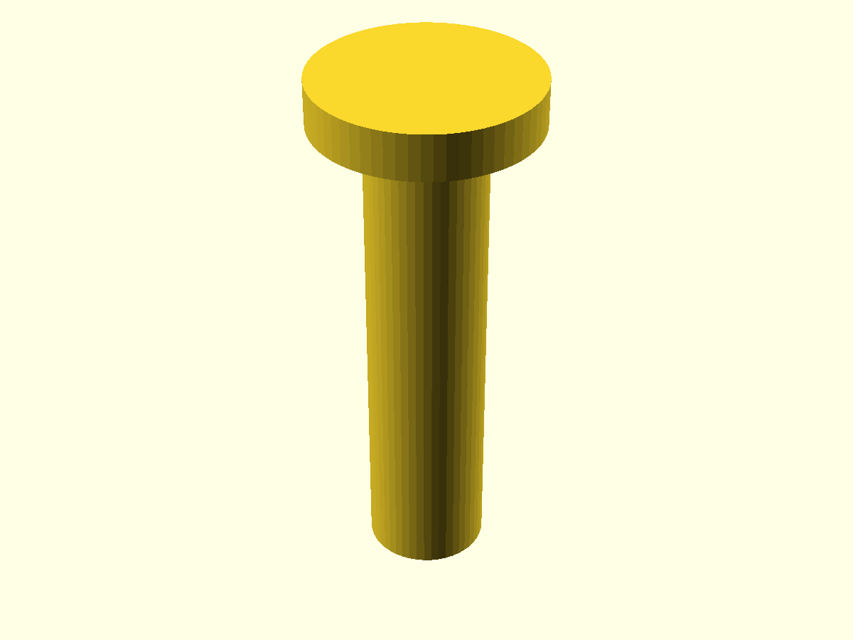
output/handoff_case/button_cap_rev_0002.png
