dmcsvoices/Handoff-Case/output/handoff_case/buttons_rev_0002_iso_bottom_back_left.png

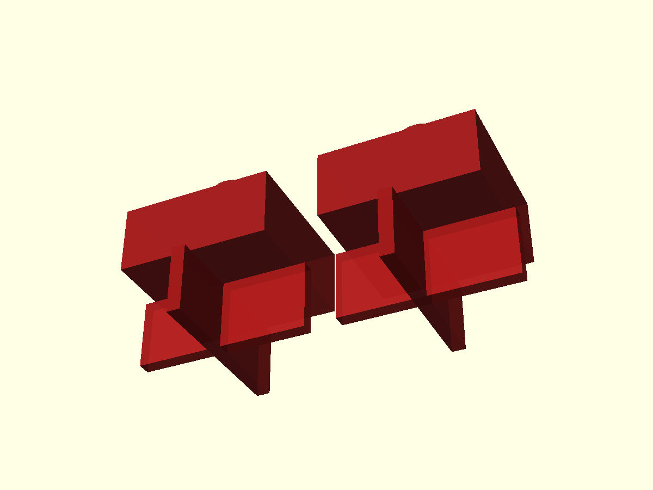
output/handoff_case/buttons_rev_0002_iso_bottom_back_left.png
