dmcsvoices/Handoff-Case/output/handoff_case/esp32_rev_0002_inspect_inside_bottom_iso.png

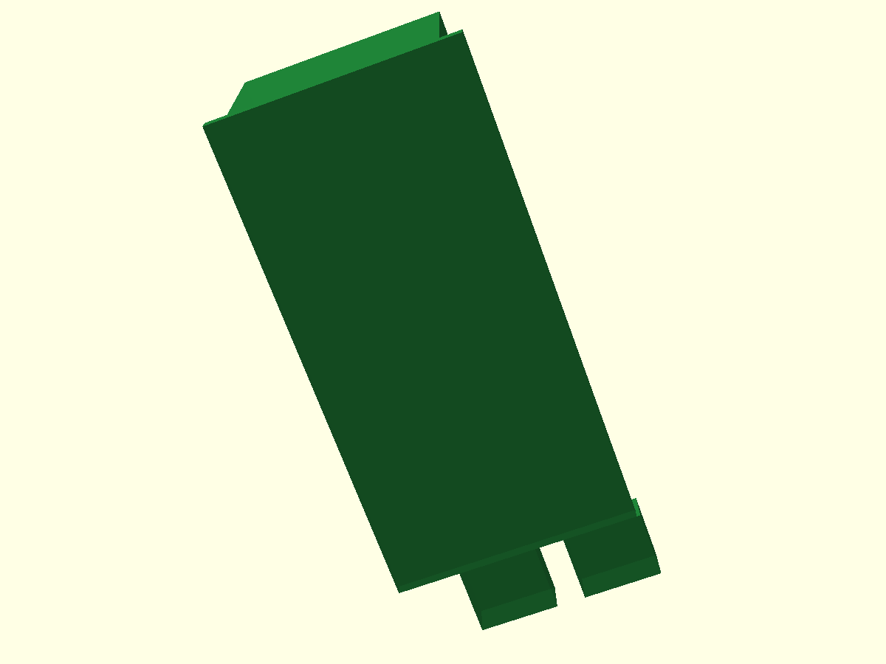
output/handoff_case/esp32_rev_0002_inspect_inside_bottom_iso.png
