dmcsvoices/Handoff-Case/output/handoff_case/lid_rev_0002_iso_back_right.png

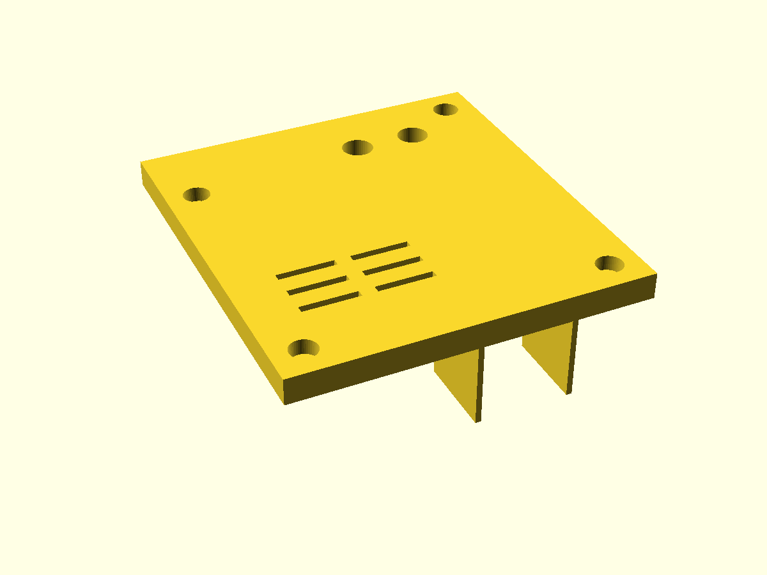
output/handoff_case/lid_rev_0002_iso_back_right.png
