dmcsvoices/Handoff-Case/output/handoff_case/lid_rev_0002_iso_bottom_front_left.png

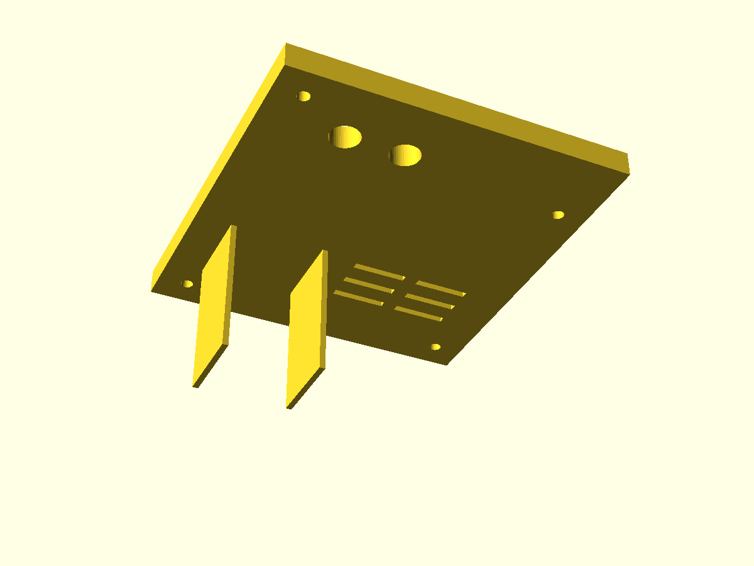
output/handoff_case/lid_rev_0002_iso_bottom_front_left.png
