dmcsvoices/Handoff-Case/output/handoff_case/lid_rev_0002_ortho_top.png

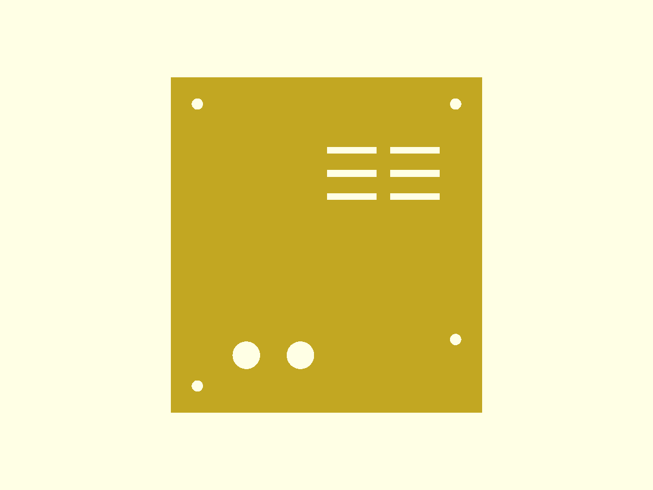
output/handoff_case/lid_rev_0002_ortho_top.png
