dmcsvoices/Handoff-Case/output/handoff_case/oled_rev_0002_inspect_inside_bottom_ortho.png

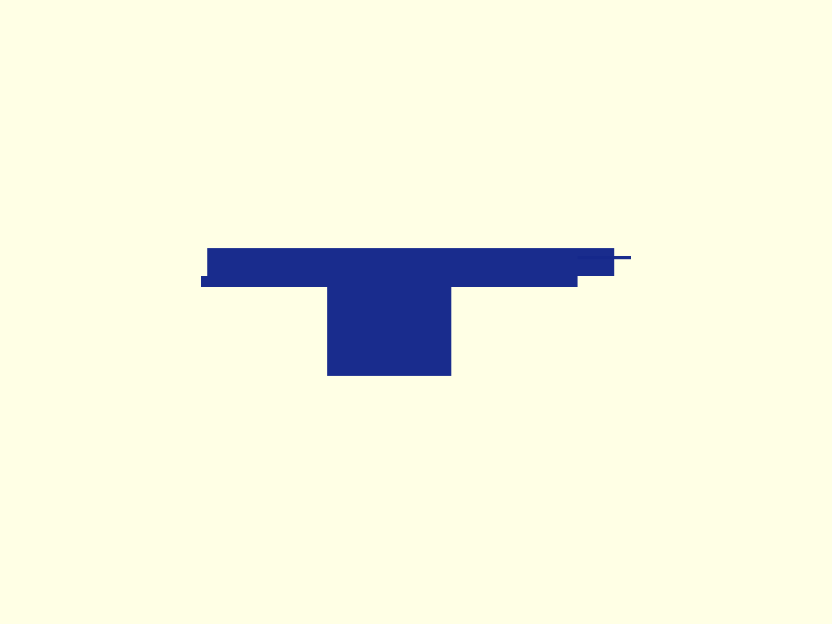
output/handoff_case/oled_rev_0002_inspect_inside_bottom_ortho.png
