dmcsvoices/Handoff-Case/output/handoff_case/sd_module_rev_0002_iso_bottom_front_right.png

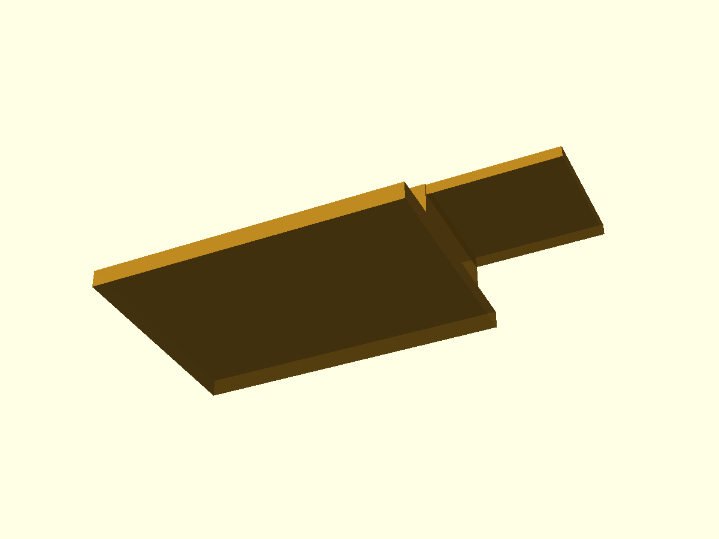
output/handoff_case/sd_module_rev_0002_iso_bottom_front_right.png
