dmcsvoices/Handoff-Case/revisions/handoff_case/rev_0002/assembly_preview_rev_0002.stl

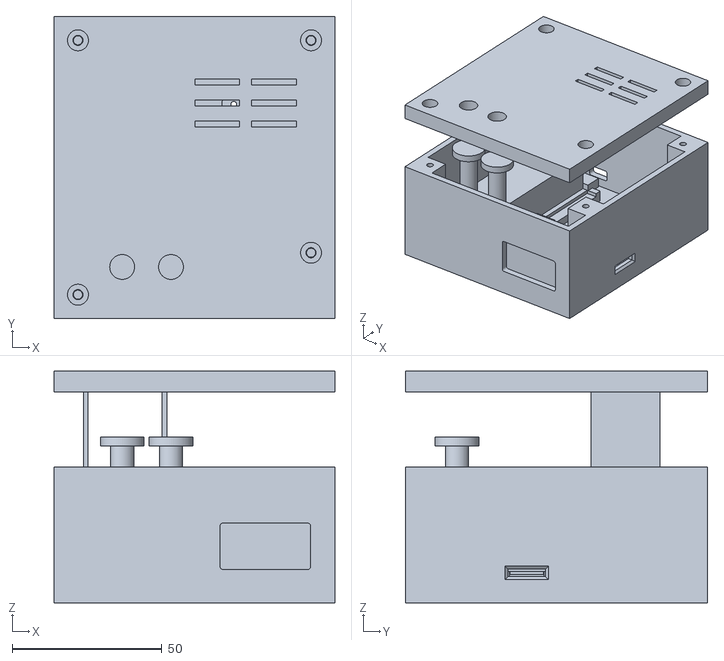
[picture p55: CAD file, 2026-10-30]
revisions/handoff_case/rev_0002/assembly_preview_rev_0002.stl
93.8 x 100.9 x 77.4
