dmcsvoices/Handoff-Case/designs/handoff_case/updated_measurements/base_rev_0001.3mf

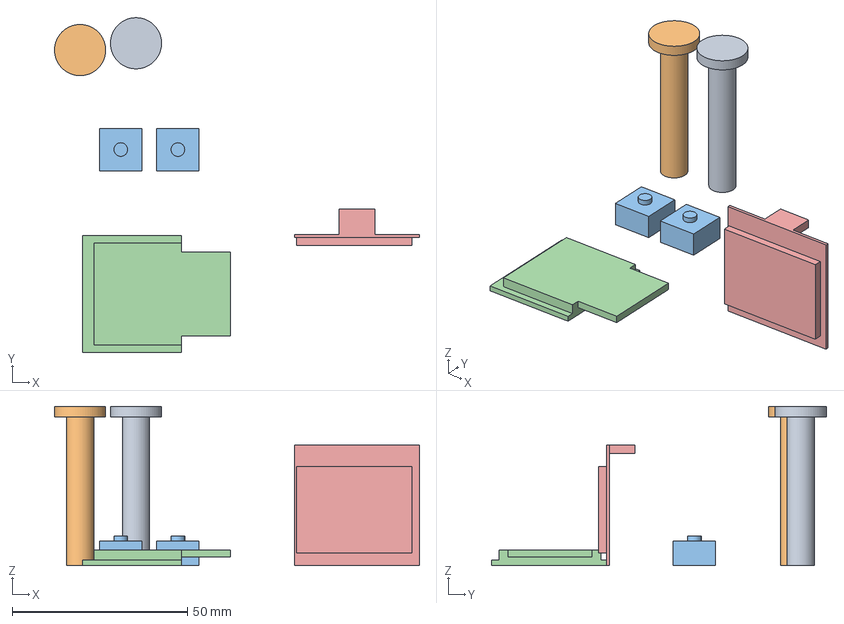
[picture p56: CAD file, 2026-10-30]
designs/handoff_case/updated_measurements/base_rev_0001.3mf
104.1 x 95.5 x 45.4 mm
button_cap_rev_0001.stl x 2
buttons_rev_0001.stl
sd_module_rev_0001.stl
oled_rev_0001.stl
