dmcsvoices/Handoff-Case/output/handoff_case/sd_module_rev_0002.stl

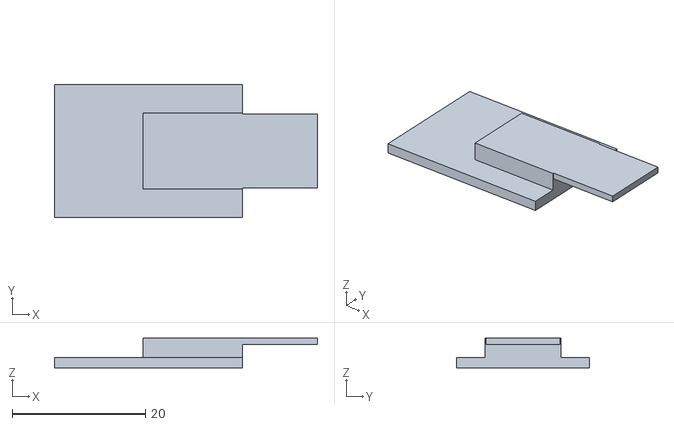
[picture p57: CAD file, 2026-10-30]
output/handoff_case/sd_module_rev_0002.stl
39.5 x 20.0 x 4.50
