dmcsvoices/Handoff-Case/output/handoff_case/oled_rev_0002.stl

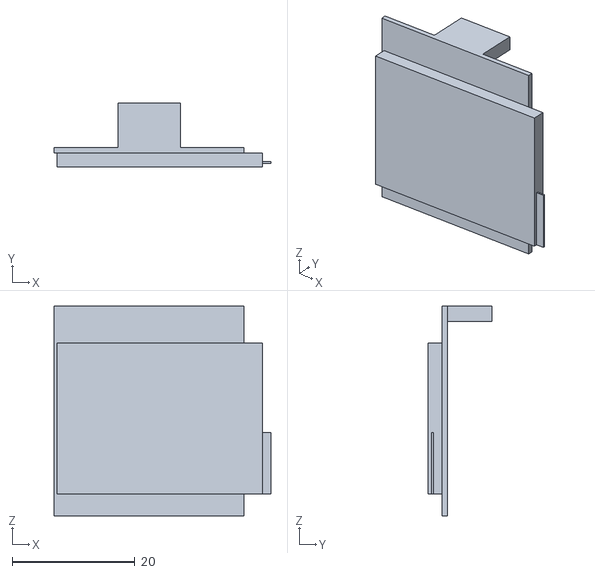
[picture p59: CAD file, 2026-10-30]
output/handoff_case/oled_rev_0002.stl
35.4 x 10.5 x 34.2
