dmcsvoices/Handoff-Case/revisions/handoff_case/rev_0002/button_cap_rev_0002.stl

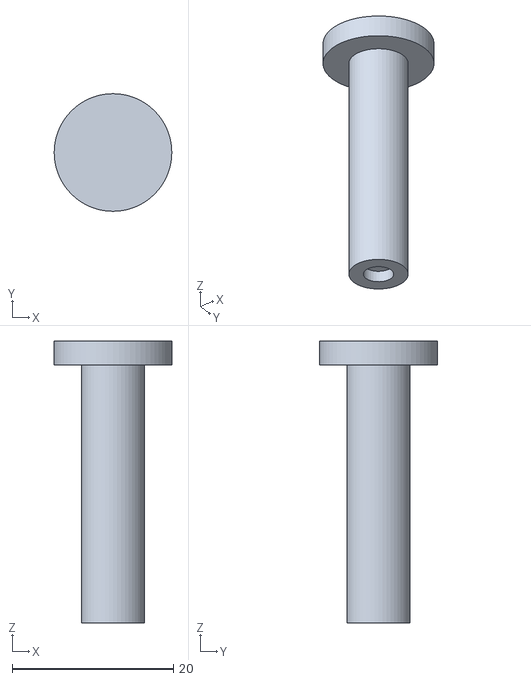
[picture p60: CAD file, 2026-10-30]
revisions/handoff_case/rev_0002/button_cap_rev_0002.stl
14.6 x 14.6 x 35.0
