dmcsvoices/Handoff-Case/output/handoff_case/esp32_rev_0002.stl

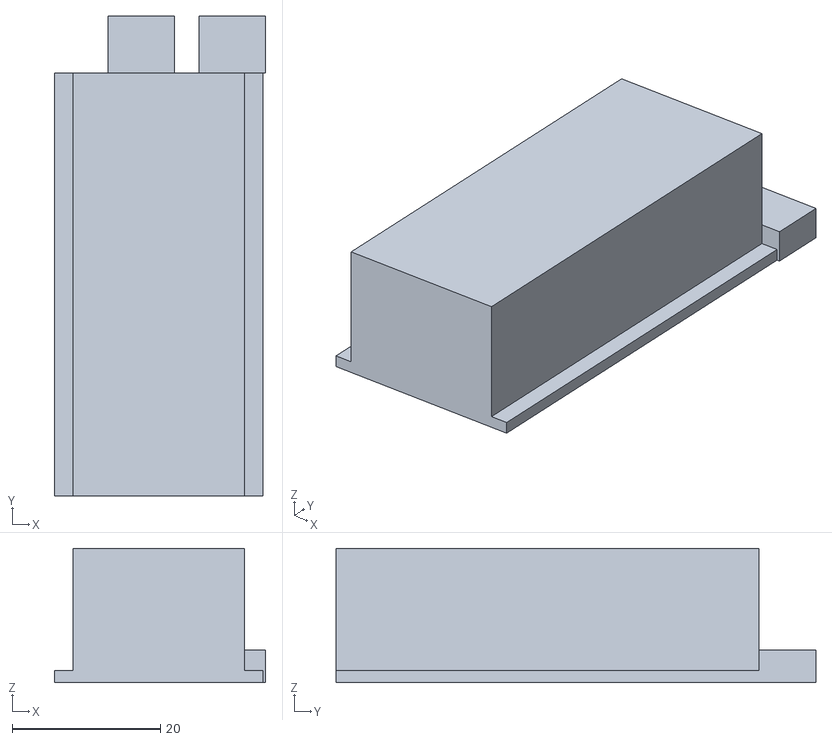
[picture p61: CAD file, 2026-10-30]
output/handoff_case/esp32_rev_0002.stl
28.5 x 64.8 x 18.1
