dmcsvoices/Handoff-Case/output/handoff_case/buttons_rev_0002.stl

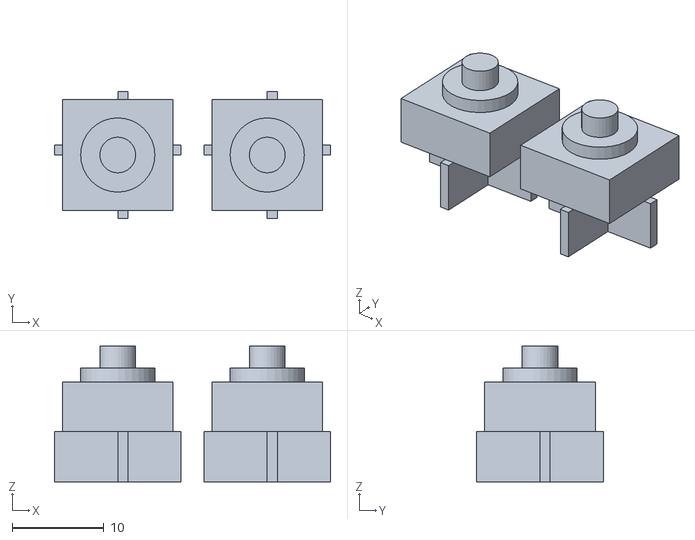
[picture p62: CAD file, 2026-10-30]
output/handoff_case/buttons_rev_0002.stl
30.1 x 13.8 x 14.8
