dmcsvoices/Handoff-Case/revisions/handoff_case/rev_0002/lid_rev_0002.stl

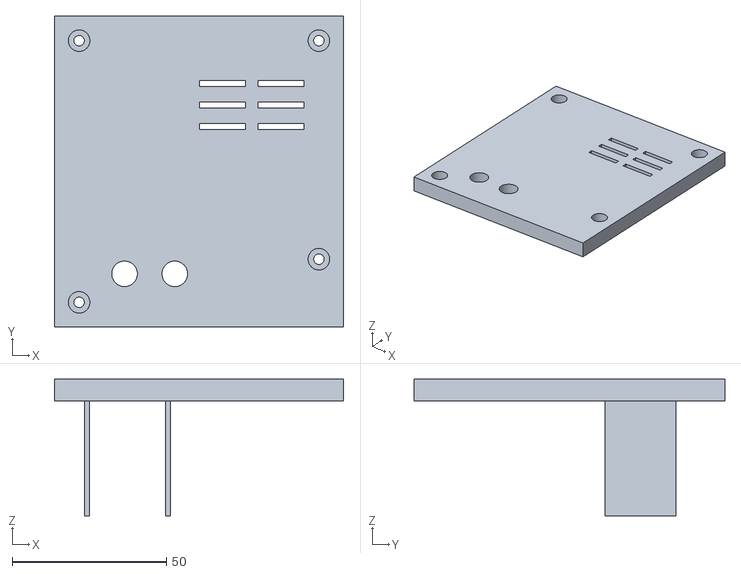
[picture p63: CAD file, 2026-10-30]
revisions/handoff_case/rev_0002/lid_rev_0002.stl
93.8 x 100.9 x 44.3
