dmcsvoices/Handoff-Case/(list of files, cad)

Other CAD files:
output/handoff_case/assembly_preview_rev_0002.stl
output/handoff_case/base_rev_0002.stl
revisions/handoff_case/rev_0002/buttons_rev_0002.stl
output/handoff_case/button_cap_rev_0002.stl
output/handoff_case/lid_rev_0002.stl
designs/handoff_case/reference/handoff_case_orig.scad
designs/handoff_case/reference/Internals-prototype.blend
