dmcsvoices/Handoff-Case/output/handoff_case/assembly_preview_rev_0002.png

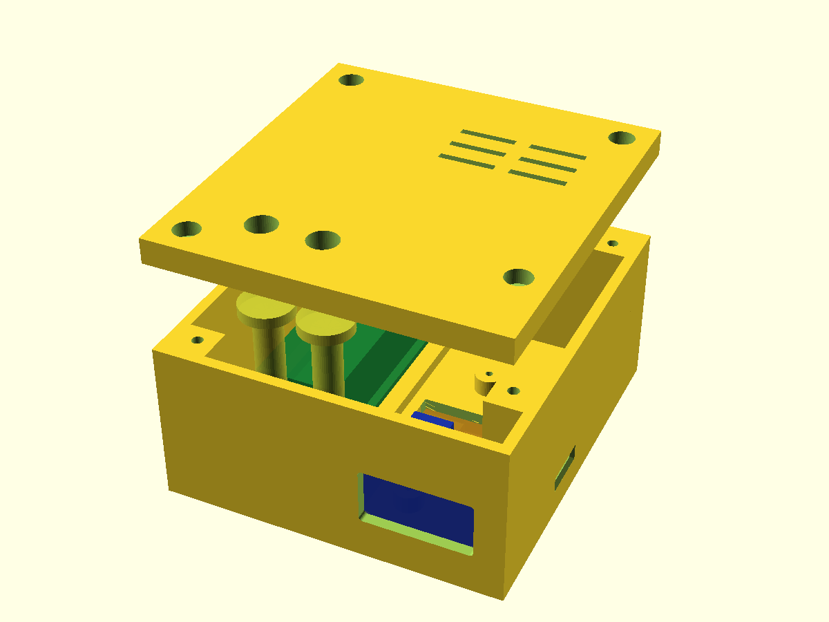
output/handoff_case/assembly_preview_rev_0002.png
