dmcsvoices/Handoff-Case/output/handoff_case/assembly_preview_rev_0002_inspect_inside_bottom_iso.png

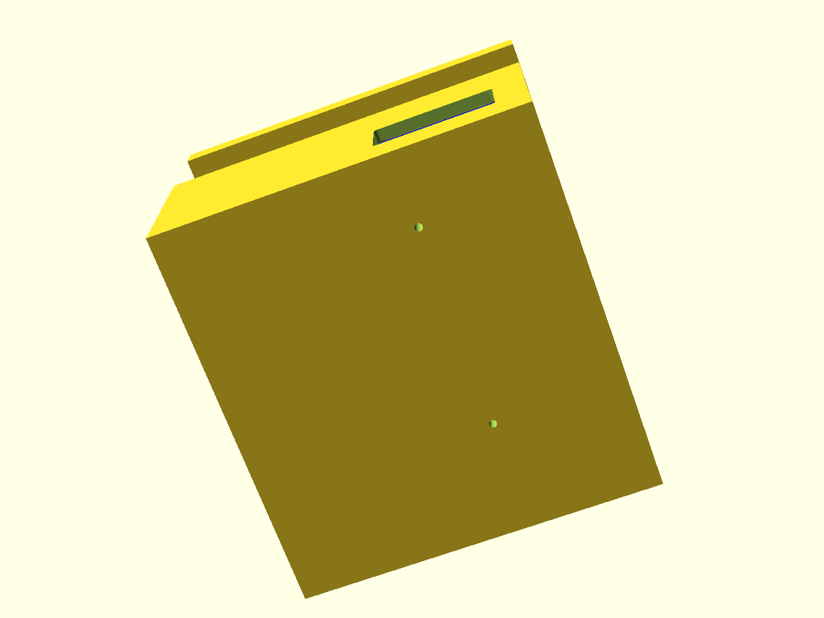
output/handoff_case/assembly_preview_rev_0002_inspect_inside_bottom_iso.png
