dmcsvoices/Handoff-Case/output/handoff_case/assembly_preview_rev_0002_iso_bottom_back_right.png

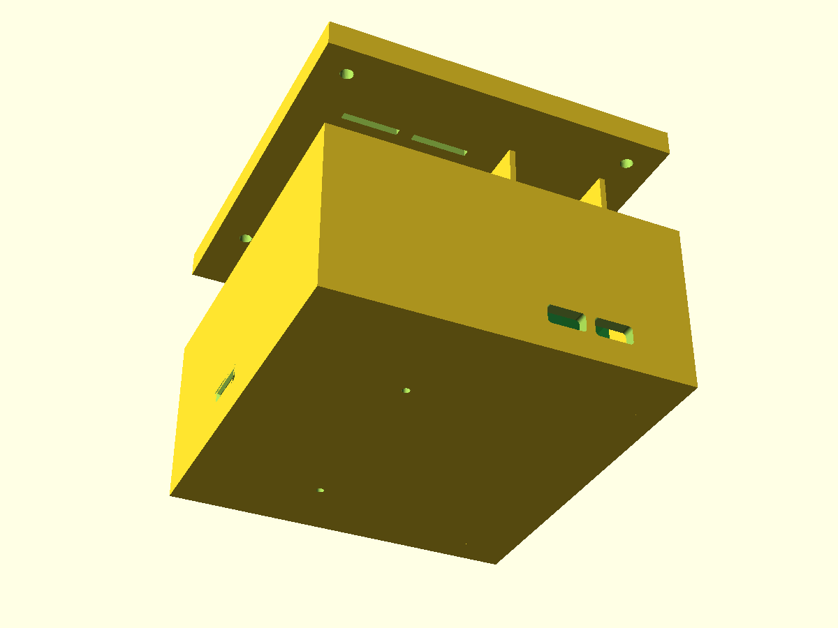
output/handoff_case/assembly_preview_rev_0002_iso_bottom_back_right.png
