dmcsvoices/Handoff-Case/output/handoff_case/assembly_preview_rev_0002_ortho_front.png

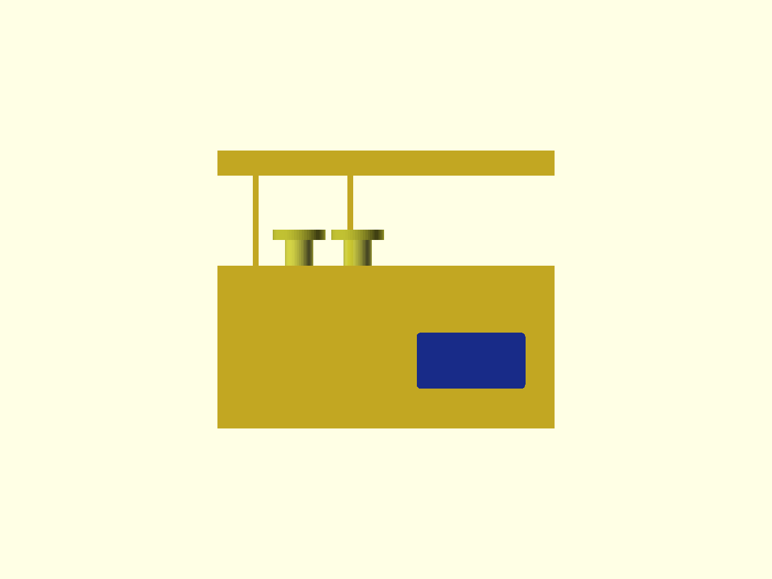
output/handoff_case/assembly_preview_rev_0002_ortho_front.png
