dmcsvoices/Handoff-Case/output/handoff_case/product_assembly_base_isolation.png

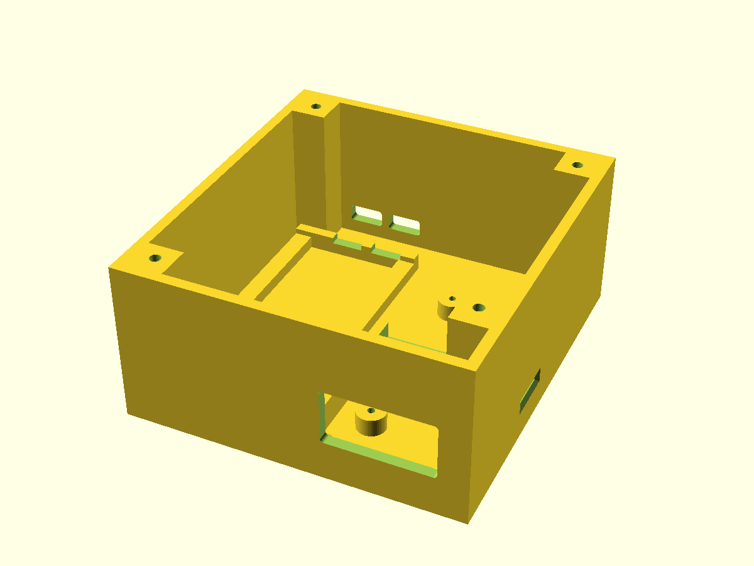
output/handoff_case/product_assembly_base_isolation.png
