dmcsvoices/Handoff-Case/output/handoff_case/product_assembly_exploded.png

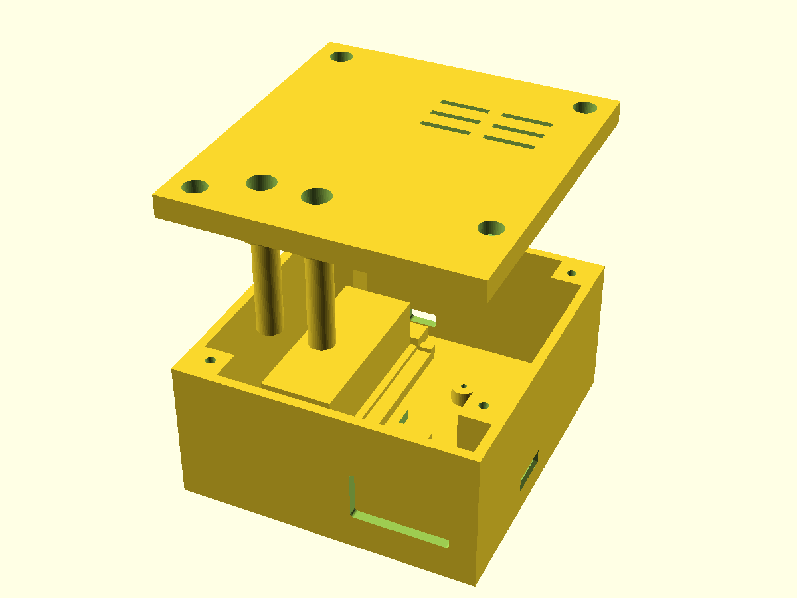
output/handoff_case/product_assembly_exploded.png
