dmcsvoices/Handoff-Case/output/handoff_case/product_assembly_interior_iso.png

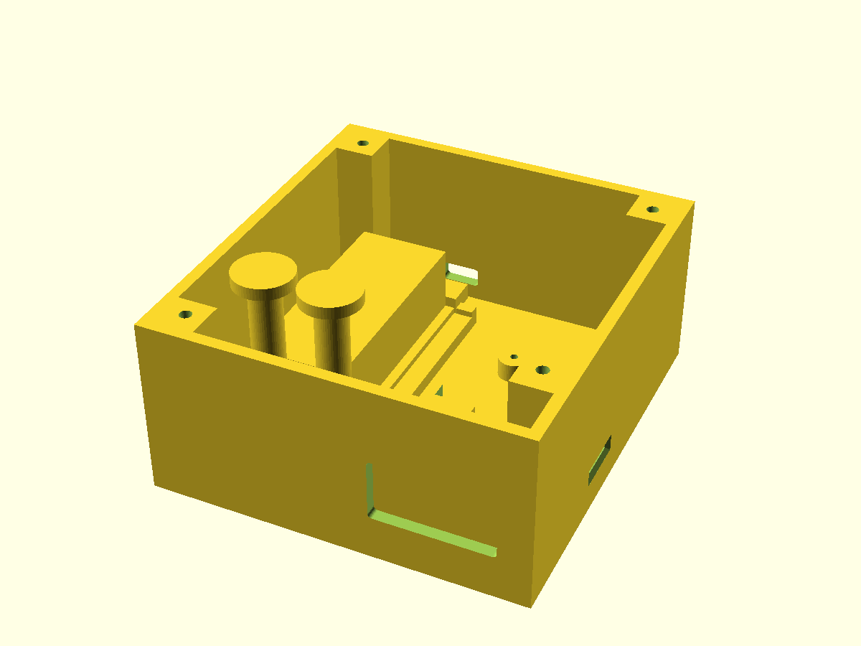
output/handoff_case/product_assembly_interior_iso.png
