dmcsvoices/Handoff-Case/output/handoff_case/product_assembly_lid_isolation.png

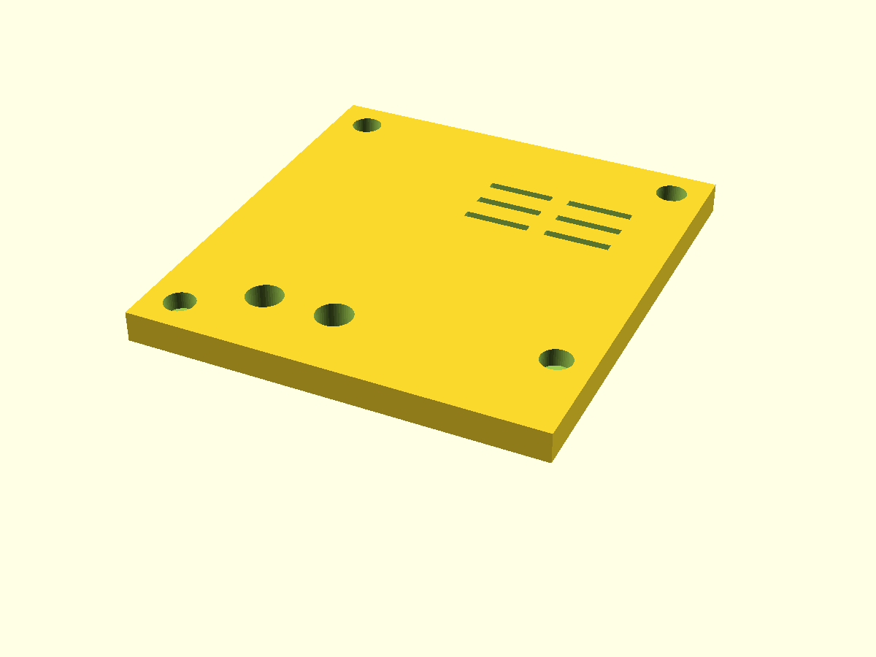
output/handoff_case/product_assembly_lid_isolation.png
