dmcsvoices/Handoff-Case/designs/handoff_case/updated_measurements/IMG_20261029_181527797.jpg

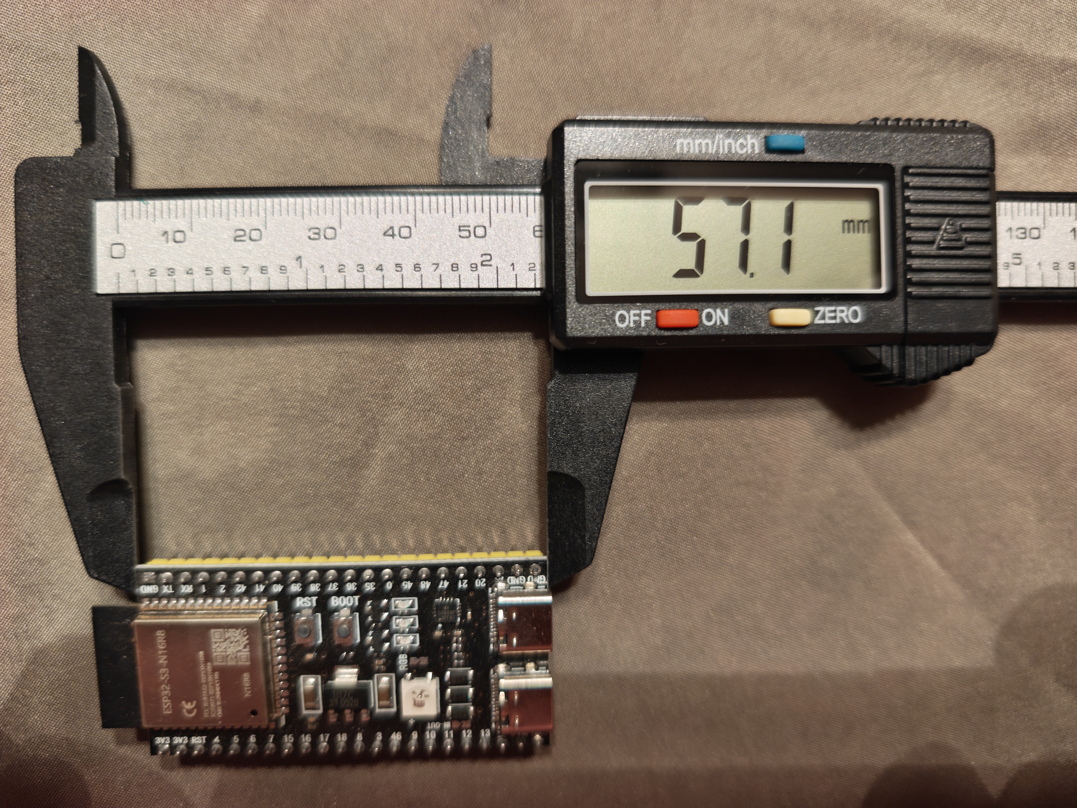
designs/handoff_case/updated_measurements/IMG_20261029_181527797.jpg
