dmcsvoices/Handoff-Case/designs/handoff_case/updated_measurements/IMG_20261029_181608045.jpg

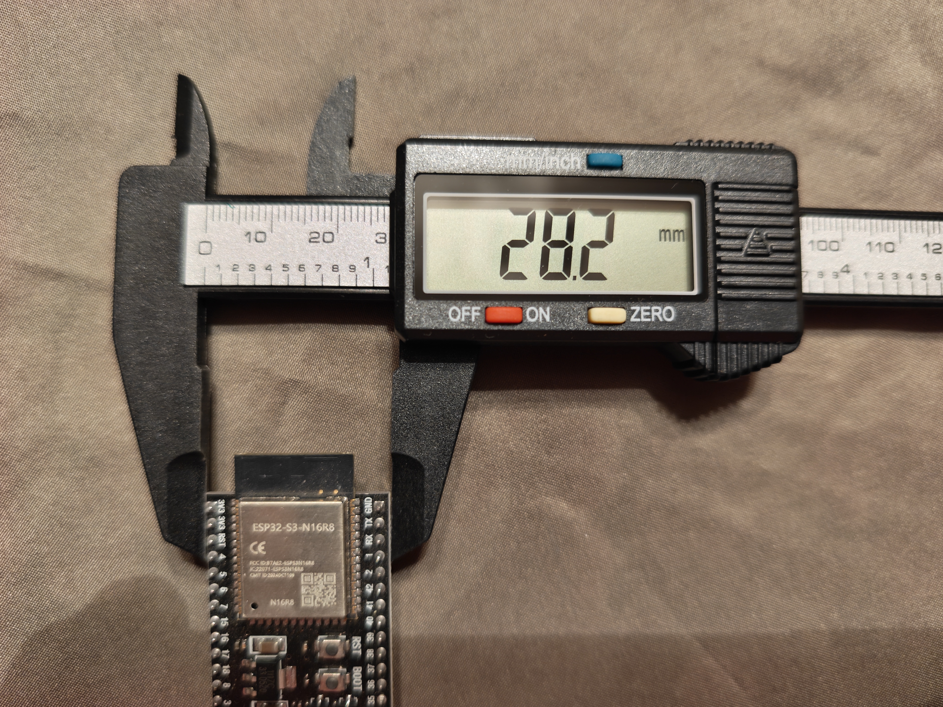
designs/handoff_case/updated_measurements/IMG_20261029_181608045.jpg
