dmcsvoices/Handoff-Case/designs/handoff_case/updated_measurements/IMG_20261029_181804995.jpg

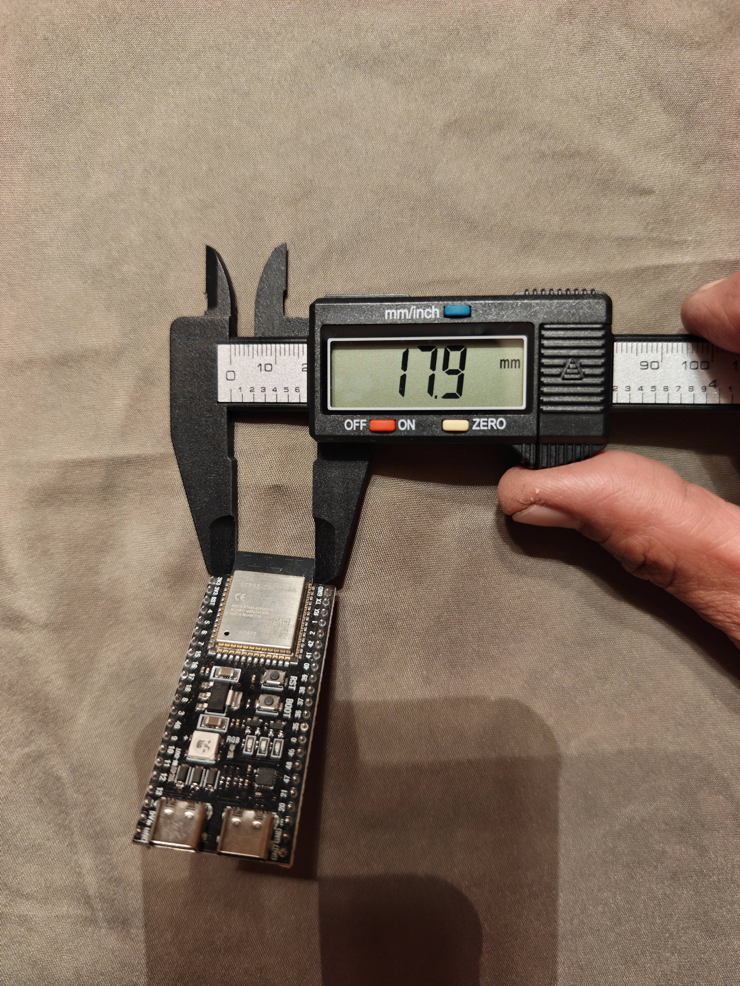
designs/handoff_case/updated_measurements/IMG_20261029_181804995.jpg
