dmcsvoices/Handoff-Case/designs/handoff_case/updated_measurements/IMG_20261029_182742721.jpg

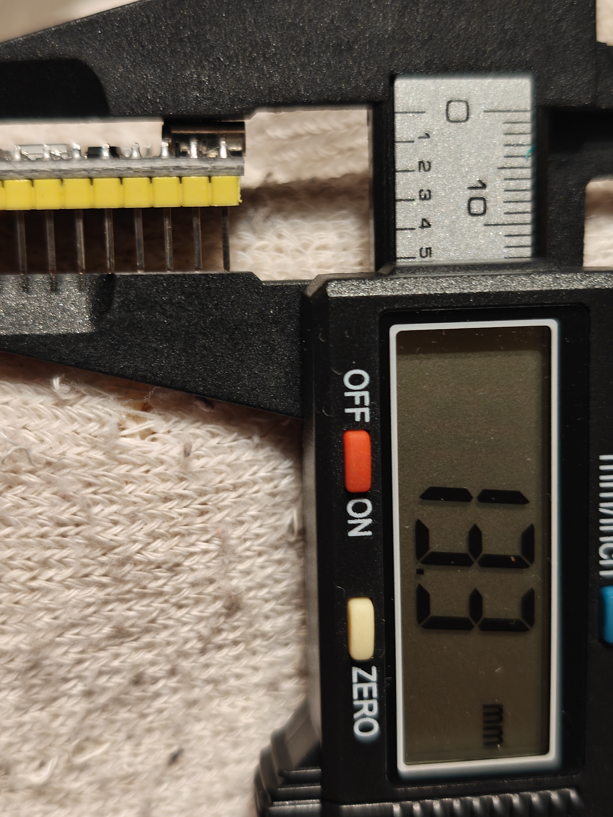
designs/handoff_case/updated_measurements/IMG_20261029_182742721.jpg
