dmcsvoices/Handoff-Case/designs/handoff_case/updated_measurements/IMG_20261029_182748810.jpg

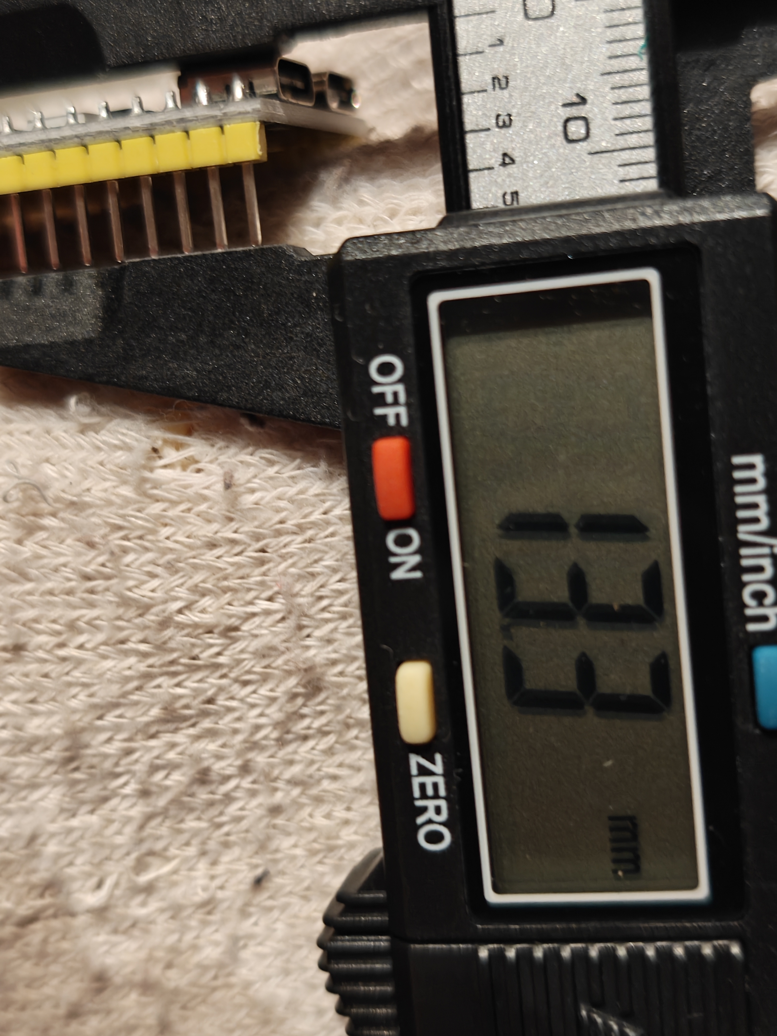
designs/handoff_case/updated_measurements/IMG_20261029_182748810.jpg
