dmcsvoices/Handoff-Case/designs/handoff_case/updated_measurements/IMG_20261029_182821010.jpg

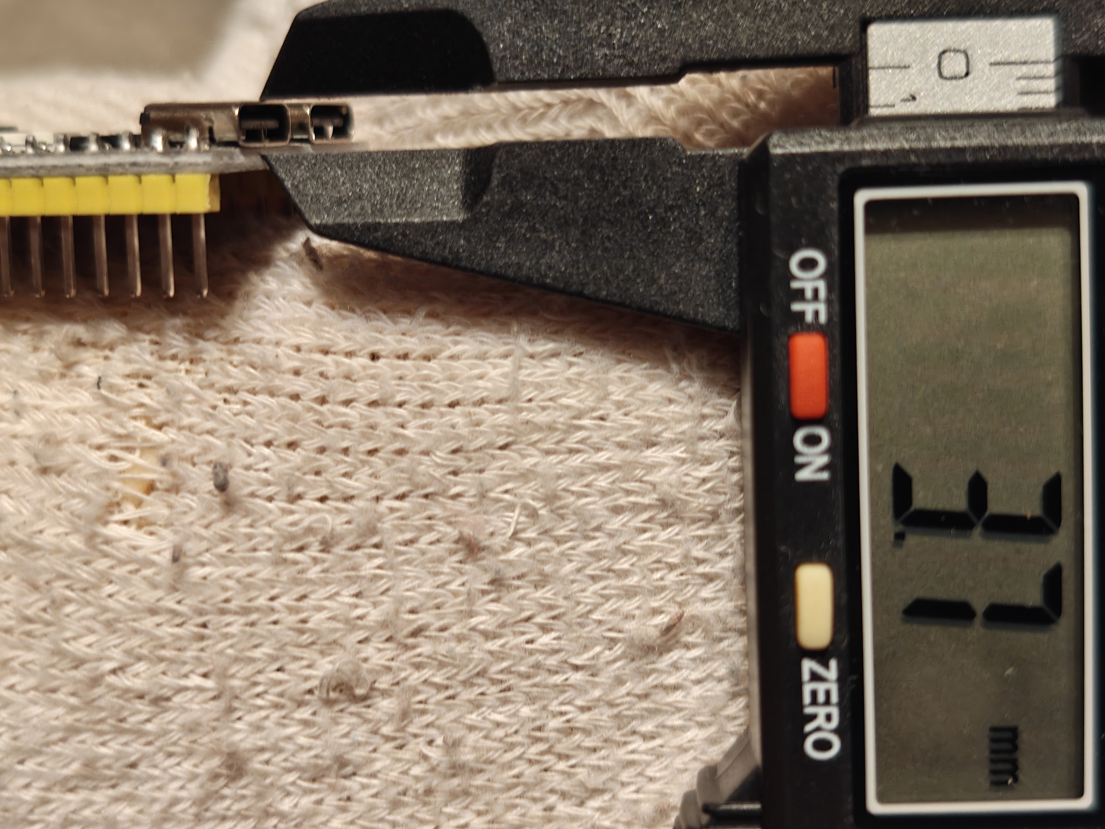
designs/handoff_case/updated_measurements/IMG_20261029_182821010.jpg
