dmcsvoices/Handoff-Case/designs/handoff_case/updated_measurements/IMG_20261029_182917933.jpg

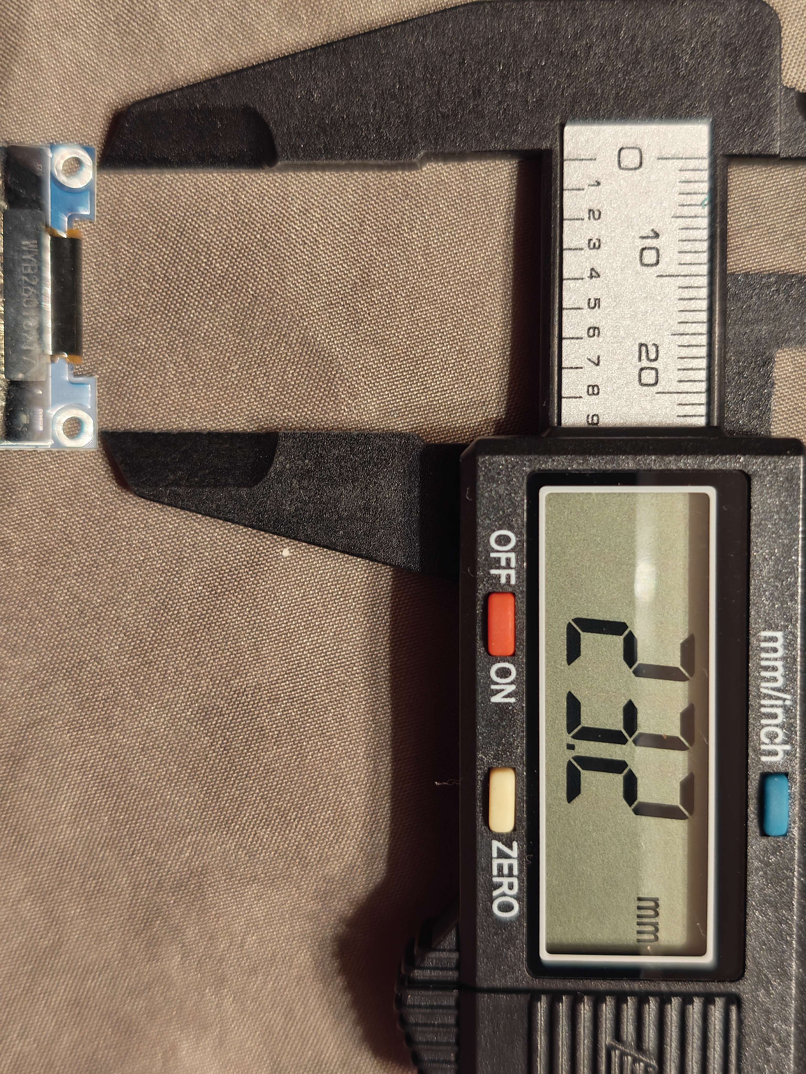
designs/handoff_case/updated_measurements/IMG_20261029_182917933.jpg
