dmcsvoices/Handoff-Case/designs/handoff_case/updated_measurements/IMG_20261029_182920592.jpg

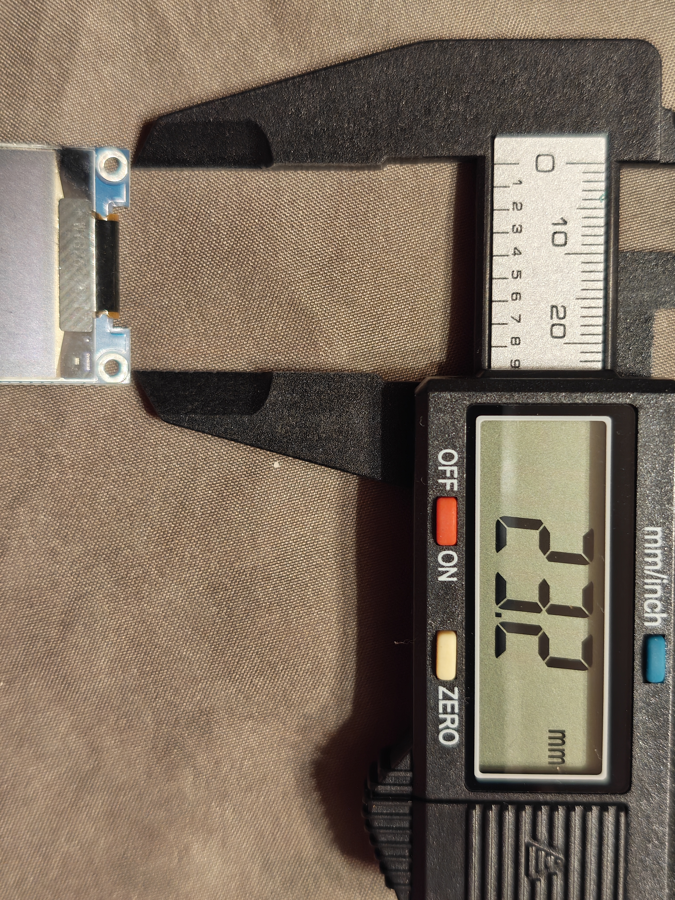
designs/handoff_case/updated_measurements/IMG_20261029_182920592.jpg
