dmcsvoices/Handoff-Case/designs/handoff_case/updated_measurements/IMG_20261029_182941906.jpg

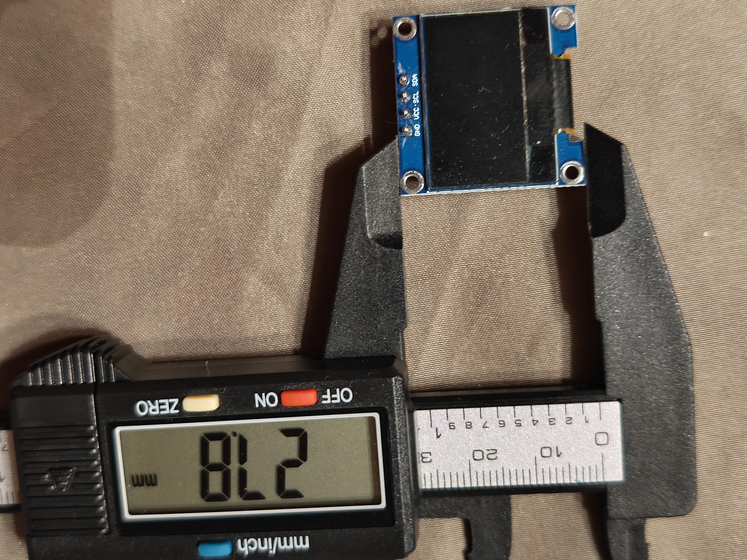
designs/handoff_case/updated_measurements/IMG_20261029_182941906.jpg
