dmcsvoices/Handoff-Case/designs/handoff_case/updated_measurements/IMG_20261029_183047161.jpg

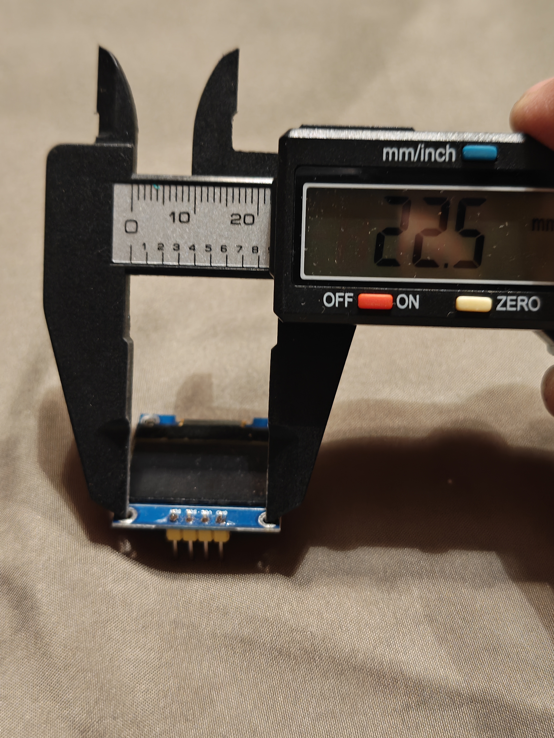
designs/handoff_case/updated_measurements/IMG_20261029_183047161.jpg
