dmcsvoices/Handoff-Case/designs/handoff_case/updated_measurements/IMG_20261029_183049609.jpg

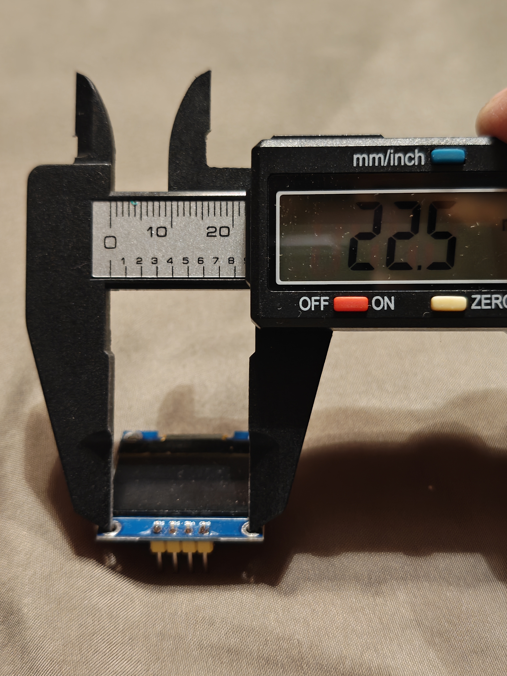
designs/handoff_case/updated_measurements/IMG_20261029_183049609.jpg
