dmcsvoices/Handoff-Case/designs/handoff_case/updated_measurements/IMG_20261029_183716244.jpg

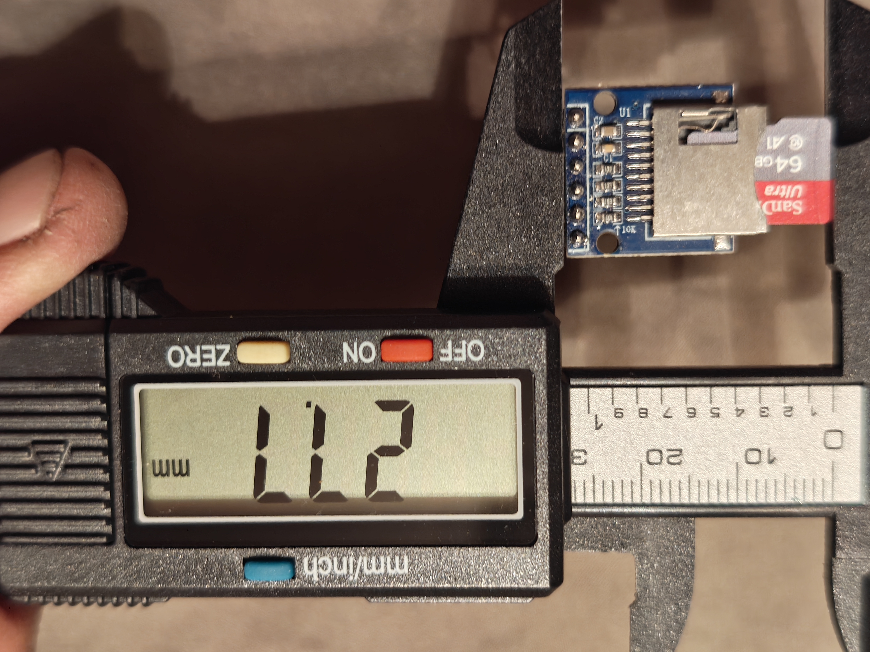
designs/handoff_case/updated_measurements/IMG_20261029_183716244.jpg
