dmcsvoices/Handoff-Case/designs/handoff_case/updated_measurements/IMG_20261029_183944752.jpg

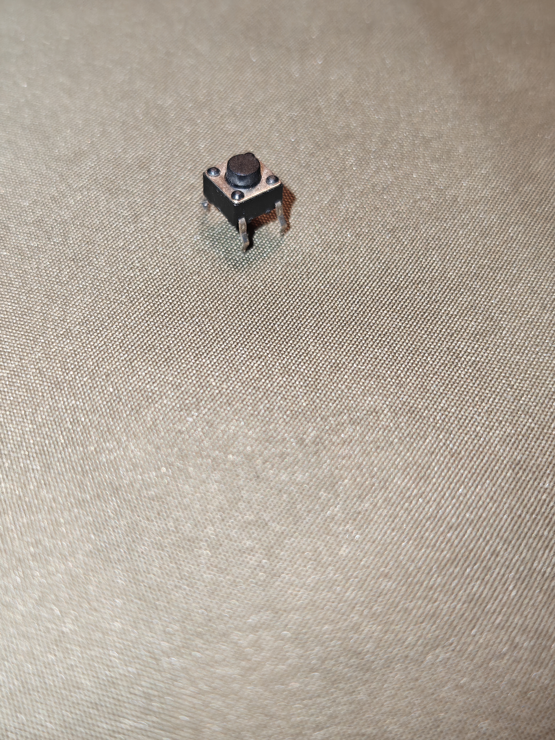
designs/handoff_case/updated_measurements/IMG_20261029_183944752.jpg
