dmcsvoices/Handoff-Case/designs/handoff_case/updated_measurements/IMG_20261029_184527845.jpg

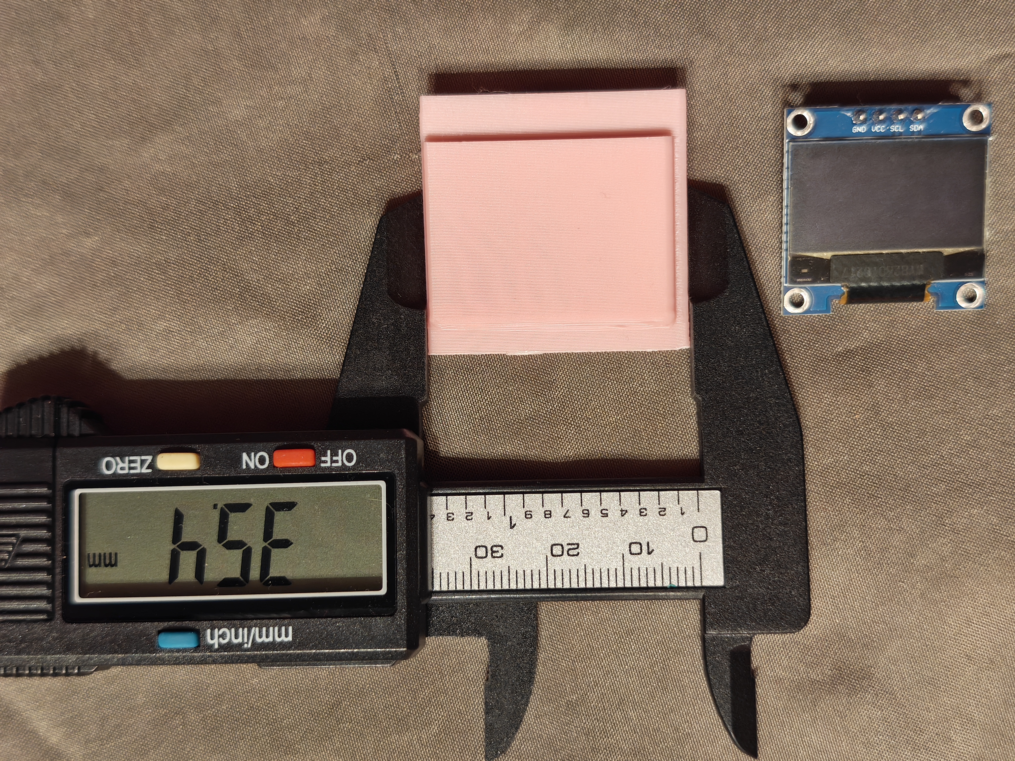
designs/handoff_case/updated_measurements/IMG_20261029_184527845.jpg
