dmcsvoices/Handoff-Case/designs/handoff_case/updated_measurements/IMG_20261029_184600120.jpg

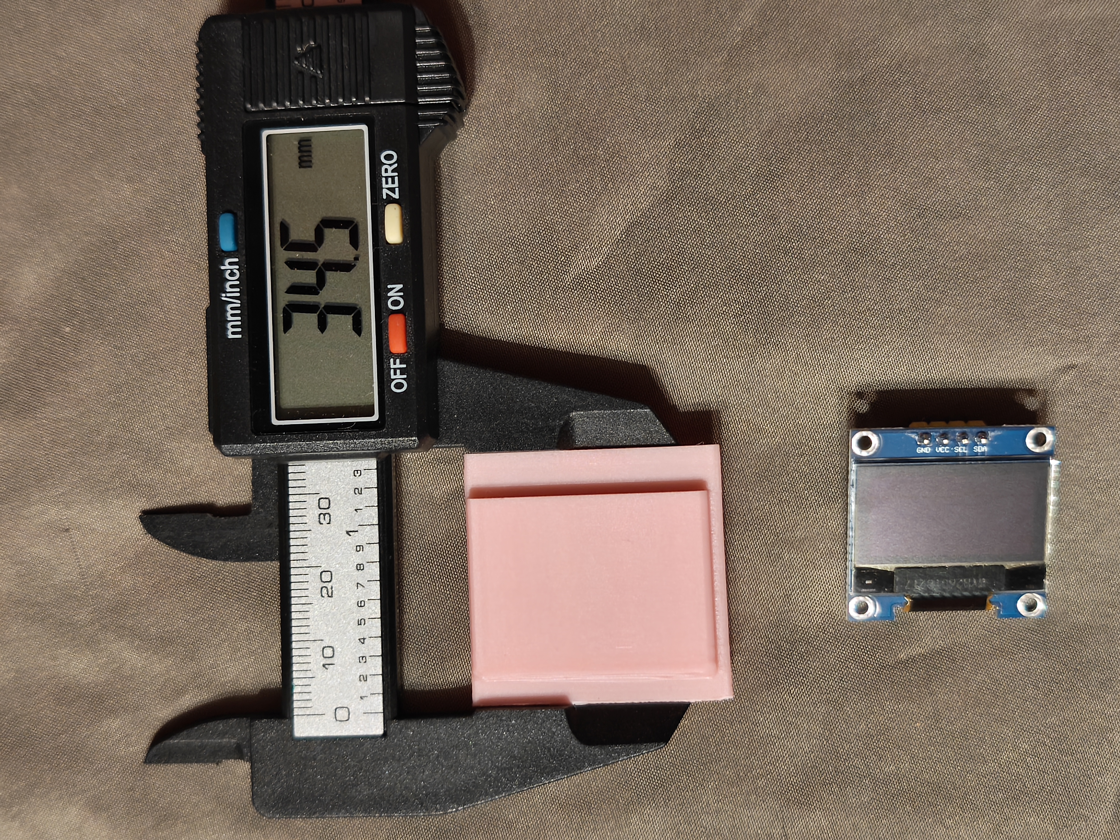
designs/handoff_case/updated_measurements/IMG_20261029_184600120.jpg
