dmcsvoices/Handoff-Case/designs/handoff_case/updated_measurements/IMG_20261029_184808596.jpg

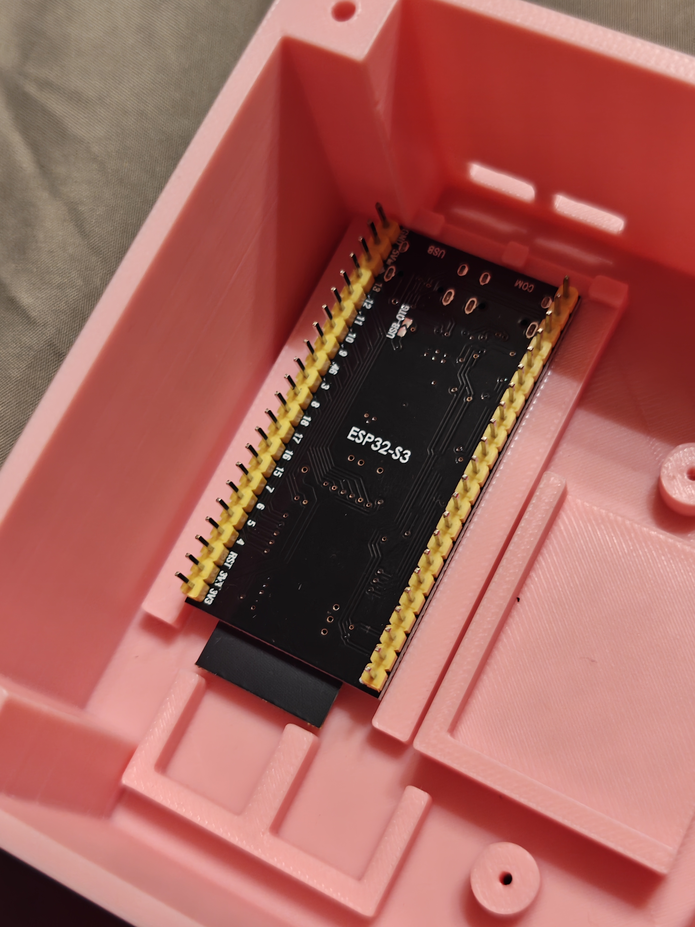
designs/handoff_case/updated_measurements/IMG_20261029_184808596.jpg
