dmcsvoices/Handoff-Case/designs/handoff_case/updated_measurements/IMG_20261029_184921705.jpg

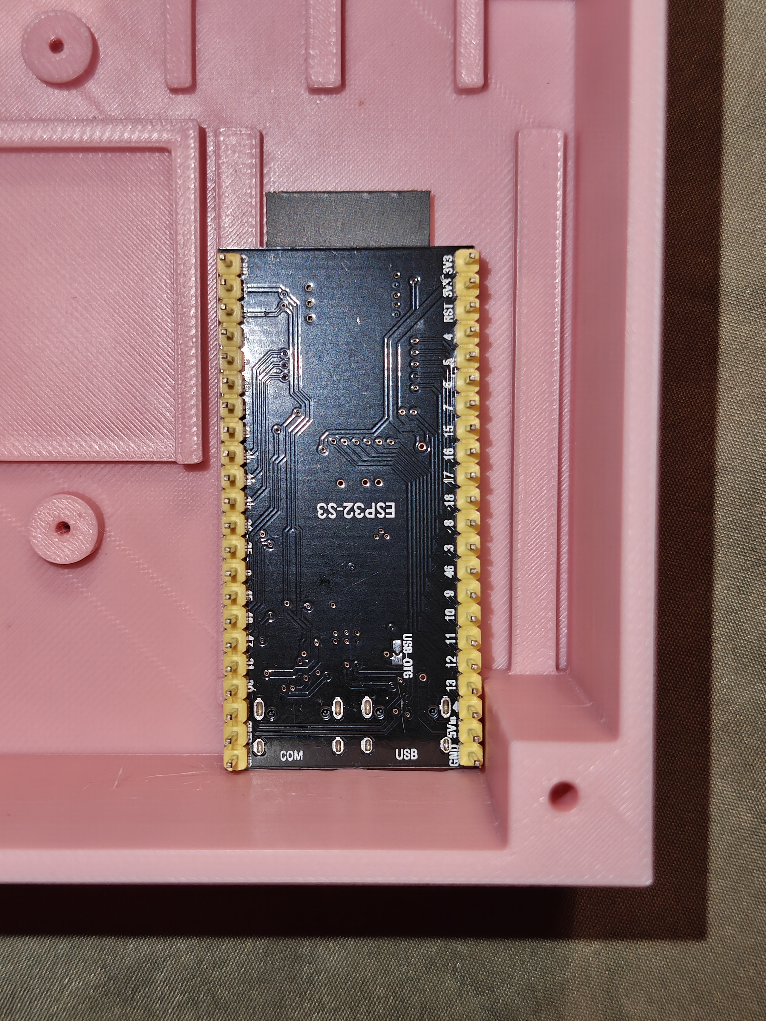
designs/handoff_case/updated_measurements/IMG_20261029_184921705.jpg
