dmcsvoices/Handoff-Case/designs/handoff_case/updated_measurements/IMG_20261029_185009256.jpg

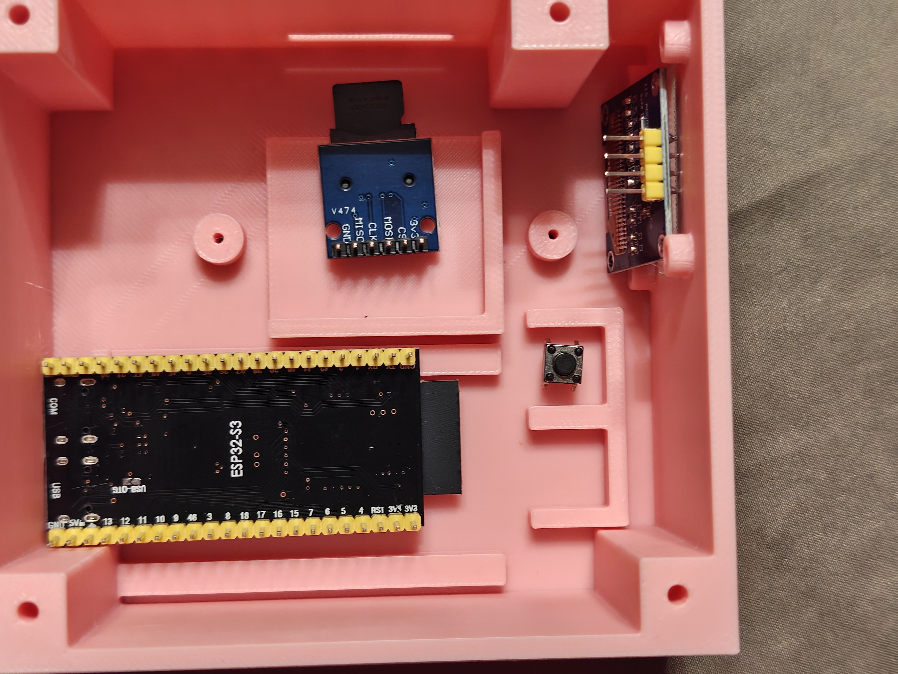
designs/handoff_case/updated_measurements/IMG_20261029_185009256.jpg
