dmcsvoices/Handoff-Case/journal/2026-10-29.md

# Journal: 2026-10-29

## Field Ownership

- User-only: `Today's Intentions`, `Notes / Reflections`
- Agent-managed: `Kickoff Context`, `Plan Checkpoint Linkage`, `Repo Work Log`

## Today's Intentions

-

## Kickoff Context

- Date: 2026-10-29
- Journal file status: created today (agent-managed)
- Relevant plans: `plans/current/2026-10-29-20-30-00_handoff-case-rev2-feedback.md`
- Missing artifacts created: `designs/handoff_case/configs/rev_0002.json`,
  `revisions/handoff_case/rev_0002/` (immutable snapshot),
  `designs/handoff_case/src/probes/` (probe + coupon sources relocated from
  `designs/handoff_case/probes/`)

## Plan Checkpoint Linkage

- Active plan path: `plans/current/2026-10-29-20-30-00_handoff-case-rev2-feedback.md`
- Checklist items updated: items 1.1-1.2 (staged + published rev_0002),
  2.1-2.3 (measured parameter corrections + microSD resize + USB cutout
  derivation), 3.1-3.5 (side-entry button holding slots + cap stack +
  assembly sequence), 4.1-4.4 (build/audit/contract/sections/shells/coupon/
  assembly review), 5.1 (README feedback batch + rev_0002 sections),
  5.2 (this journal; commit/push pending explicit approval)
- Plan revisions proposed or approved: none (plan executed as written; two
  interpretation notes recorded in the design README: the slot block's
  chamber/ceiling structure, and the staged-config publication order)

## Repo Work Log

- [2026-10-29 21:05 local] Relocated `output/handoff_case/base_rev_0001.3mf`
  to `designs/handoff_case/updated_measurements/` (slicer export must not
  live in the audited flat output) [artifact governance] [none]
- [2026-10-29 21:10 local] Moved probe/coupon sources to
  `designs/handoff_case/src/probes/` and fixed their include paths
  [single source-tree home for governed probe source] [none]
- [2026-10-29 21:30 local] Staged `configs/rev_0002.json` (copy of rev_0001
  with `revision: rev_0002`) and applied the 2026-10-29 caliper batch:
  board 57.1 x 28.15, USB shell 4.4 (cutout height 5.0 derives), OLED rigid
  31.0 x 34.25 + 4.4 FPC tail, microSD module 28.2 x 20.0 + card 15.0 x
  11.1 x 1.0 (slot 12.5 x 2.5), button body 5.4 + actuator top 9.3 +
  terminal span 13.8/drop 5.5 [plan items 2.1-2.3] [none]
- [2026-10-29 22:00 local] Replaced the button wells with the side-entry
  holding-slot block (closed-top 12.4 x 5.6 x 14 slots, 3.0 floor plate
  with corner windows, shared 7.0 under-chamber, stepped outer walls
  tucking 2.0 under the front-left tower); cap stack recomputed (stem
  length 32.9, switch-cap relief 0.9); envelope pinned at rev_0001 so the
  lid stays geometry-identical (verified by STL vertex hash; anti-lift
  blade X pinned) [plan item 3] [physical assembly verification of the
  terminal drop and switch-cap height]
- [2026-10-29 22:45 local] Verified rev_0002 candidate: complete build +
  audit into `output/handoff_case/` (8 STL + 136 PNG), contract PASS, 1
  shell per printable leaf (buttons mockup = 2 by design), section probes
  1/2/10/11 + interval measurements recorded, coupon re-rendered from the
  updated source [plan item 4.1-4.3] [slicer review still outstanding]
- [2026-10-29 23:20 local] Published rev_0002: `scad_new_revision.py`
  created the config; the immutable snapshot was built by a /tmp driver
  reusing `scad_build_all` machinery because `--destination revision`
  staging is rejected by `scad_build.validate_output_directory` (framework
  regression: revision builds stage 3 levels deep, validation allows 1) -
  reported for the framework, scripts untouched (out of task scope)
  [playbook steps 6-7] [framework fix in a future maintenance task]
- [2026-10-29 23:40 local] Rebuilt `output/handoff_case/` from the
  published config path, both audits pass, artifact-bound assembly review
  rendered + audited for rev_0002 [plan item 4.4] [none]

## Notes / Reflections

-
- [2026-10-30 06:20 local] Final rev_0002 verification battery: contract
  PASS, shell/interval evidence on the final installed STLs recorded in the
  README rev_0002 verification subsection, assembly review re-rendered and
  audited against the final build manifest. Revision snapshot caveat
  recorded (source-hash predates the geometry-neutral mockup hoisting;
  geometry verified identical by vertex hashes; not re-published per the
  immutable-revision rule).
