dmcsvoices/Handoff-Case/journal/2026-10-30.md

# Journal: 2026-10-30

## Field Ownership

- User-only: `Today's Intentions`, `Notes / Reflections`
- Agent-managed: `Kickoff Context`, `Plan Checkpoint Linkage`, `Repo Work Log`
- Agents copy only verbatim user text into user-only fields; otherwise leave `-`.

## Today's Intentions

-

## Kickoff Context

- Date: 2026-10-30
- Journal file status: created new (first entry of the day)
- Relevant plans: plans/current/2026-10-29-20-30-00_handoff-case-rev2-feedback.md (checkpoint completion)
- Missing artifacts created: journal/2026-10-30.md (this file)

## Plan Checkpoint Linkage

- Active plan path: plans/current/2026-10-29-20-30-00_handoff-case-rev2-feedback.md
- Checklist items updated: 5.2 completed `[x]` (all plan items now `[x]`)
- Plan revisions proposed or approved: none

## Repo Work Log

- [2026-10-30 10:20 local] User approved the rev_0002 slot-floor 1.5 mm rim exception (recorded in the design README deviation list) and approved the rev_0002 commit+push [rev_0002 feedback checkpoint] [none]
- [2026-10-30 10:25 local] Committed and pushed the rev_0002 batch: caliper-verified parameter corrections (board 57.1, USB shell 4.4, OLED 31.0 rigid + FPC tail, microSD module resize, button 5.4 + terminal modeling), button wells replaced with side-entry holding slots + under-chamber (lid geometry-identical), rev_0002 config + immutable revision snapshot, updated cap-stack coupon, 2026-10-29 measurement photo batch, verification records, journals [plan item 5.2] [reprint base + 2 caps + coupon from rev_0002; lid unchanged]

## Notes / Reflections

-
