dmcsvoices/Handoff-Case/journal/2026-10-21.md

# Journal: 2026-10-21

## Field Ownership

- User-only: `Today's Intentions`, `Notes / Reflections`
- Agent-managed: `Kickoff Context`, `Plan Checkpoint Linkage`, `Repo Work Log`
- Agents copy only verbatim user text into user-only fields; otherwise leave `-`.

## Today's Intentions

-

## Kickoff Context

- Date: 2026-10-21
- Journal file status: created new (first entry of the day)
- Relevant plans: plans/current/2026-10-20-14-26-10_handoff-case.md (checkpoint/push items)
- Missing artifacts created: journal/2026-10-21.md (this file)

## Plan Checkpoint Linkage

- Active plan path: plans/current/2026-10-20-14-26-10_handoff-case.md
- Checklist items updated: none today (item 5.2 push executed)
- Plan revisions proposed or approved: none

## Repo Work Log

- [2026-10-21 09:55 local] Pushed main to new remote handoff (https://github.com/dmcsvoices/Handoff-Case.git); origin (cjtrowbridge/vibe-modeling) left unchanged [user provided writable remote after 403 on origin] [remote 'handoff' added; large-file warning on pre-existing 97.5 MB output/cicero_joined STL - no action taken]
- [2026-10-21 09:56 local] Recorded push in this journal and committed it [journal policy] [none]
- [2026-10-21 10:05 local] Made dmcsvoices/Handoff-Case the permanent origin (git remote set-url origin + removed the temporary 'handoff' remote) [user directive] [none]

## Notes / Reflections

-
