dmcsvoices/Handoff-Case/journal/2026-10-20.md

# Journal: 2026-10-20

## Field Ownership

- User-only: `Today's Intentions`, `Notes / Reflections`
- Agent-managed: `Kickoff Context`, `Plan Checkpoint Linkage`, `Repo Work Log`
- Agents copy only verbatim user text into user-only fields; otherwise leave `-`.

## Today's Intentions

-

## Kickoff Context

- Date: 2026-10-20
- Journal file status: created new (first entry of the day)
- Relevant plans: plans/current/2026-10-20-14-26-10_handoff-case.md (created, approved, executed through item 3.1)
- Missing artifacts created: journal/2026-10-20.md (this file)

## Plan Checkpoint Linkage

- Active plan path: plans/current/2026-10-20-14-26-10_handoff-case.md
- Checklist items updated: 1.1, 1.2, 2.1, 2.2, 2.3, 3.1 completed `[x]`; 3.2-3.4, 4.1-4.3, 5.1-5.2 pending
- Plan revisions proposed or approved: none (one documented deviation, no plan change needed: the ESP32 board's USB edge is a *short* edge, so the approved "USB at back wall" layout fixes the board's 60.7 mm axis along Y; documented in designs/handoff_case/README.md)

## Repo Work Log

- [2026-10-20 14:26 local] Copied 32 component photos from ~/Desktop/HandoffCase to designs/handoff_case/ and prior-attempt sources to designs/handoff_case/reference/ [user-directed handoff intake] [none]
- [2026-10-20 15:10 local] Four-way photo measurement pass over all 32 photos; consolidated dimension/provenance table written to designs/handoff_case/README.md [plan item 1] [caliper verification of flagged provisional dims before final print]
- [2026-10-20 15:40 local] Created handoff_case pipeline scaffold: src/{main,lib/defaults,parts/*}, configs/rev_0001.json, parts.json (8 parts), assembly.json (contract validation PASS) [plan items 2.1-2.3] [none]
- [2026-10-20 16:30 local] Blockout geometry built; complete manifest build into output/handoff_case/ (8 STL + 136 PNG + build_manifest.json, audit PASS); derived internal envelope 87.8 x 94.9 x 42.4 mm, outer 92.8 x 100.9 x 48.4 mm [plan item 3.1] [user review of blockout renders; detail geometry 3.2-3.4 next]
- [2026-10-20 18:20 local] Detail geometry built (rails+end stop, OLED bosses+window, SD pocket+slot, USB cutouts, button wells, M3 towers, lid with cap bores+anti-lift blades+vents, real caps); rebuild 8 STL + 136 PNG, audit PASS, contract PASS [plan items 3.2-3.4] [four sub-3.0 deviations presented to user for approval; verification gate 4.1-4.3 next]
- [2026-10-20 21:40 local] Verification evidence: 9 section probes + STL line-section measurements recorded in README 4.1 (incl. one real defect found+fixed: lid blades rendered as phantom box at origin; fixed with eager-bound helper, re-verified 5 renders); 4.2 clearance table + cap-stack coupon (3 press variants) recorded, coupon/probe source preserved at designs/handoff_case/probes/ (moved out of output for flat-audit compliance; note src/ is hash-audited so probes cannot live there). User approved the three sub-3.0 exceptions. Build audit PASS (8 STL + 136 PNG + manifest, flat 145). [plan items 4.1, 4.2 marked done; 4.3 assembly review render launched as long-running background job]
- [2026-10-21 09:45 local] 4.3 closed: full assembly review rendered + audited PASS (manifest binds build_manifest + STL hashes; unified output 8 STL + 147 PNG + 2 manifests, flat); review PNGs inspected. Plan items 1.1-4.3 all complete. Root README design list updated. [plan item 4.3] [item 5: commit checkpoint - user approval requested]
- Nothing committed yet. git tree has new untracked designs/handoff_case/, output/handoff_case/, plans/current updates, journal/2026-10-20.md, and modified README.md.

## Notes / Reflections

-
