dmcsvoices/Handoff-Case/revisions/handoff_case/rev_0002/base_rev_0002_iso_back_left.png

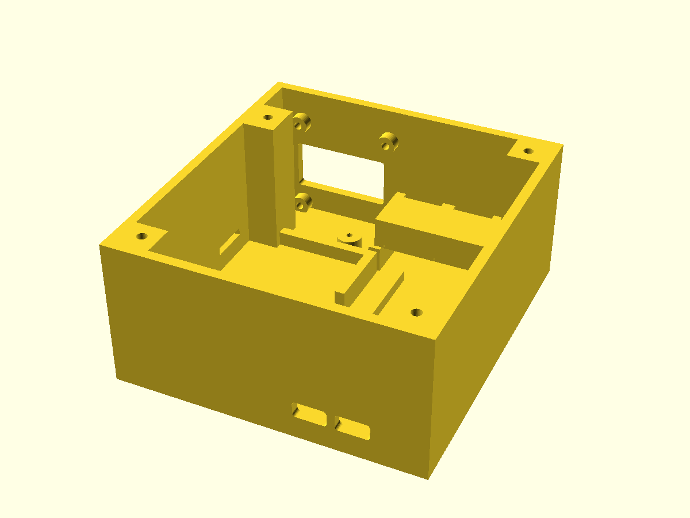
revisions/handoff_case/rev_0002/base_rev_0002_iso_back_left.png
