dmcsvoices/Handoff-Case/revisions/handoff_case/rev_0002/buttons_rev_0002.png

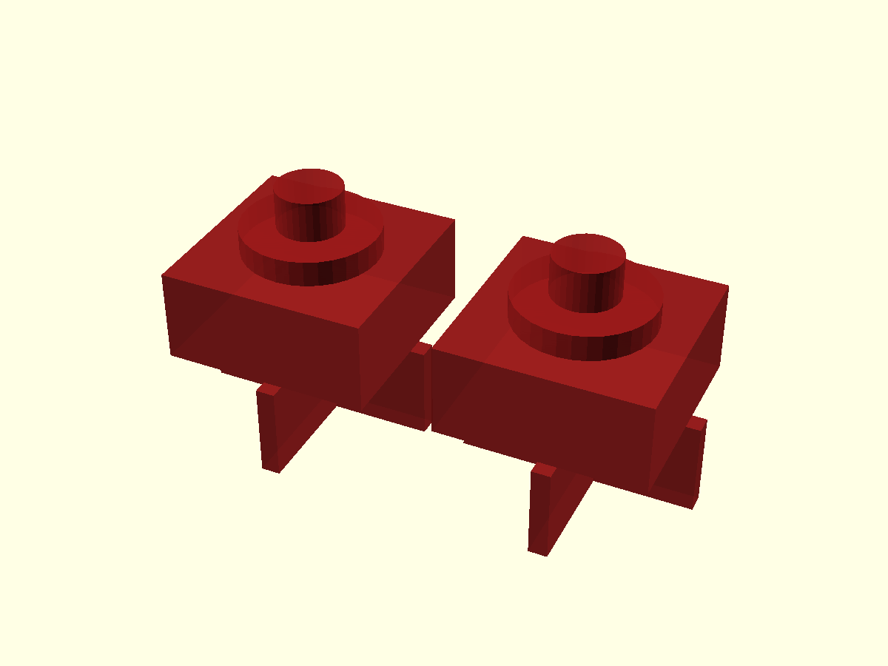
revisions/handoff_case/rev_0002/buttons_rev_0002.png
