dmcsvoices/Handoff-Case/revisions/handoff_case/rev_0002/esp32_rev_0002_iso_back_right.png

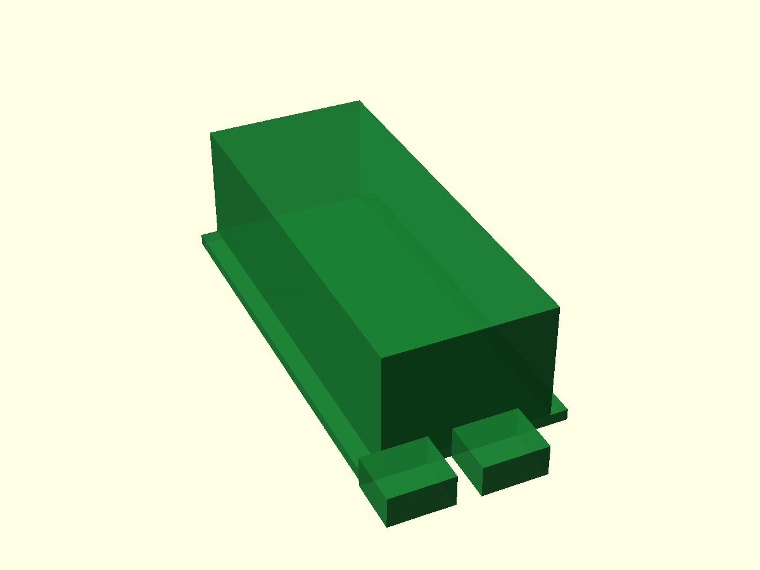
revisions/handoff_case/rev_0002/esp32_rev_0002_iso_back_right.png
