dmcsvoices/Handoff-Case/revisions/handoff_case/rev_0002/esp32_rev_0002_ortho_left.png

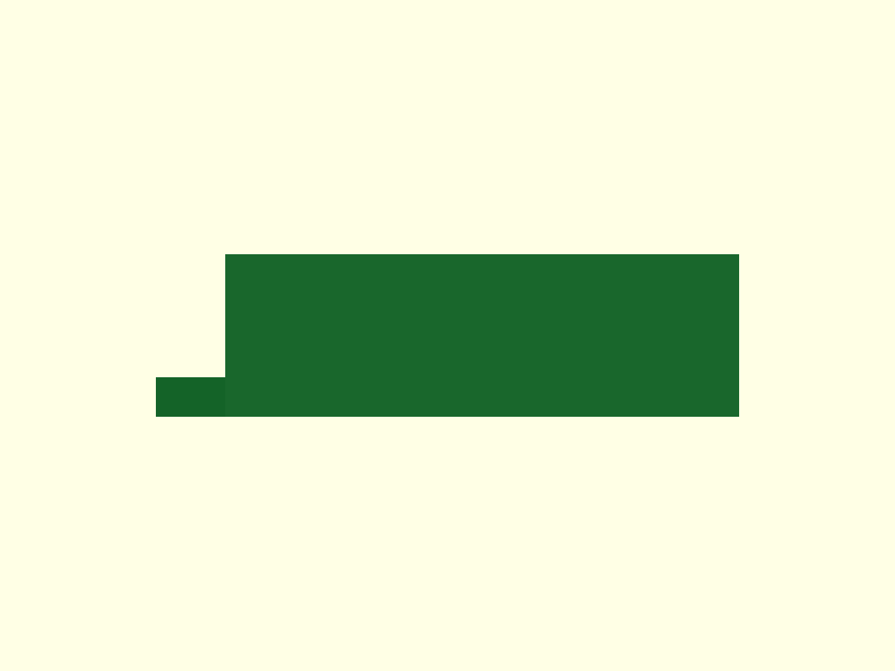
revisions/handoff_case/rev_0002/esp32_rev_0002_ortho_left.png
