dmcsvoices/Handoff-Case/revisions/handoff_case/rev_0002/lid_rev_0002_inspect_inside_bottom_iso.png

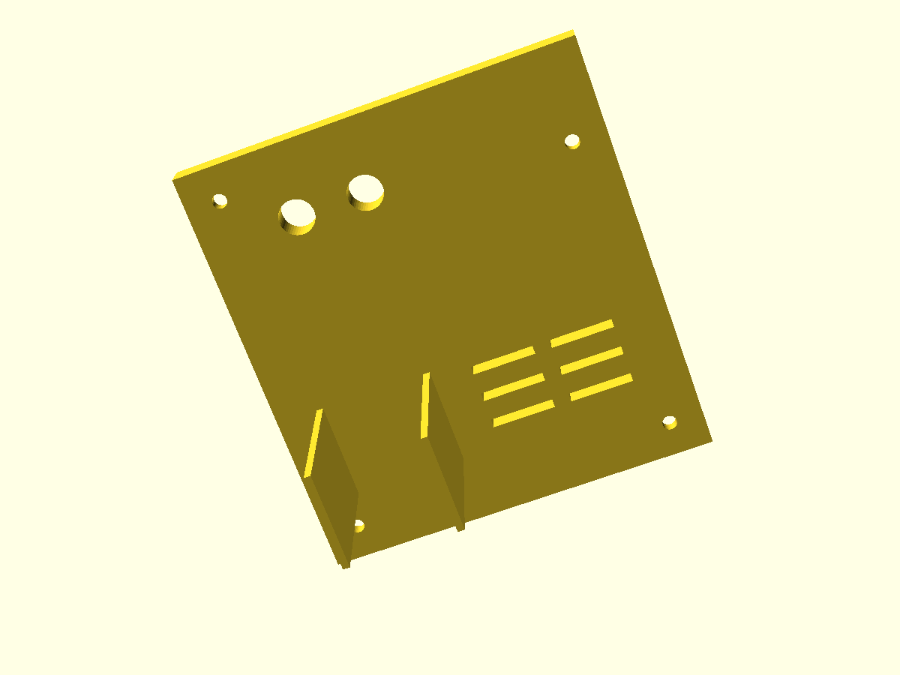
revisions/handoff_case/rev_0002/lid_rev_0002_inspect_inside_bottom_iso.png
