dmcsvoices/Handoff-Case/revisions/handoff_case/rev_0002/lid_rev_0002_ortho_back.png

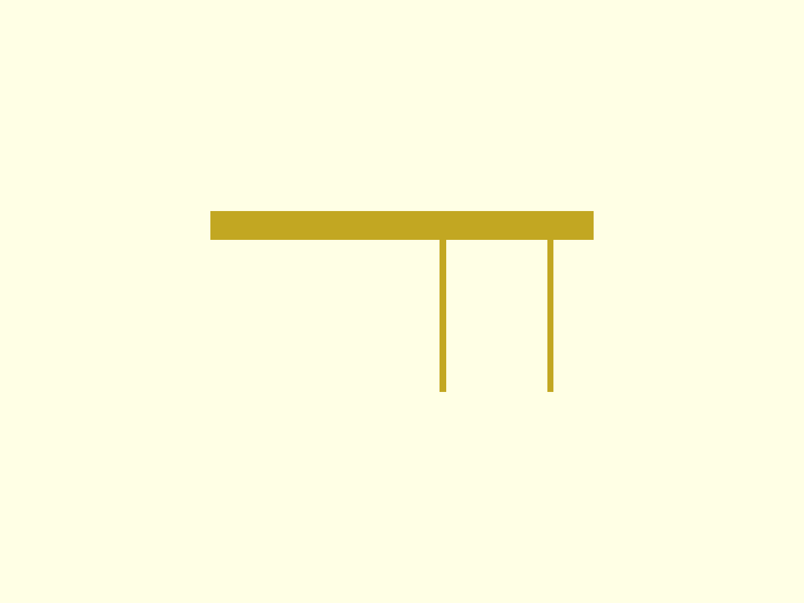
revisions/handoff_case/rev_0002/lid_rev_0002_ortho_back.png
