dmcsvoices/Handoff-Case/revisions/handoff_case/rev_0002/oled_rev_0002_iso_bottom_back_right.png

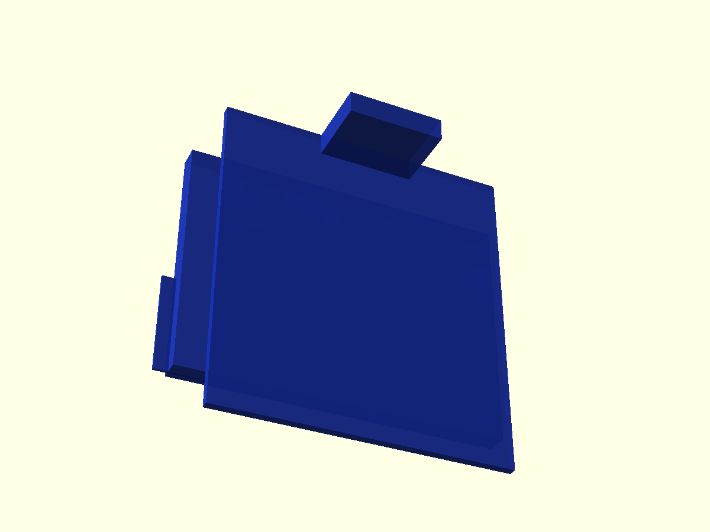
revisions/handoff_case/rev_0002/oled_rev_0002_iso_bottom_back_right.png
