dmcsvoices/Handoff-Case/revisions/handoff_case/rev_0002/sd_module_rev_0002.png

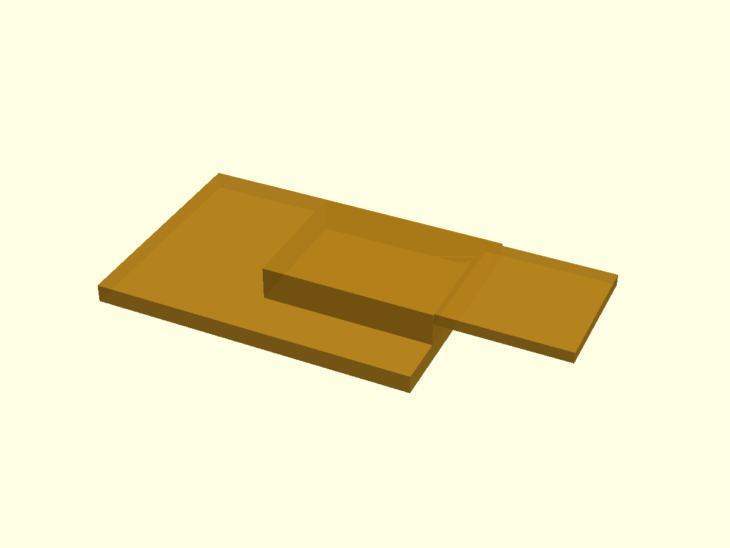
revisions/handoff_case/rev_0002/sd_module_rev_0002.png
