dmcsvoices/Handoff-Case/(commit log)

2026-10-21 Add handoff_case: governed ESP32-S3 IoT enclosure (rev_0001, fully verified)
    [Internals-prototype.blend, assembly_preview_rev_0001.stl, assembly_review.scad, base.scad, base_rev_0001.stl, button_cap.scad, button_cap_rev_0001.stl, buttons_rev_0001.stl]
2026-10-21 Journal: make dmcsvoices/Handoff-Case the permanent origin
2026-10-30 handoff_case rev_0002: caliper-verified feedback batch + side-entry button holding slots
    Measured parameter corrections (board 57.1, USB shell 4.4, OLED 31.0 rigid + FPC tail, microSD module, button 5.4 + terminals); button wells replaced with side-entry holding slots + under-chamber (lid geometry-identical); rev_0002 config + immutable snapshot; verification records + journals.
    [assembly_preview_rev_0001.stl, assembly_preview_rev_0002.stl, base.scad, base_rev_0001.3mf, base_rev_0001.stl, base_rev_0002.stl, button_cap.scad, button_cap_rev_0001.stl]
